bfrigon/alarm-clock-v2/README.md

alarm-clock
===========

3D Model render:

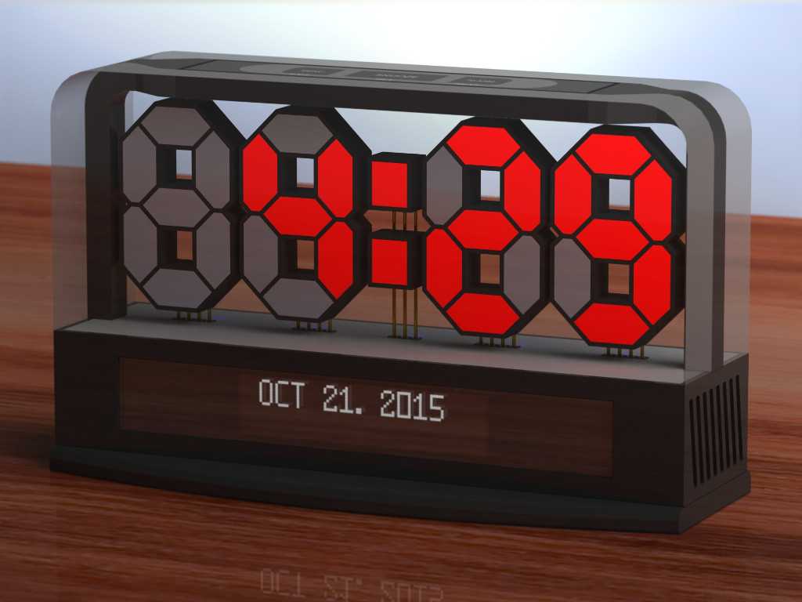
[picture p1: docs/model-render/front.jpg]
Front view
