bfrigon/alarm-clock-v2/drawings/mechanical/README.md

Index
-----

Doc ID        | Part #            | Description
--------------|-------------------|-------------------------------------------------
CLKV2-DWG-01  | CLKV2-PC-01       | RGB seven-segments digit - PCB
CLKV2-DWG-02  | CLKV2-ML-01       | RGB seven-segments digit - Diffuser shell
CLKV2-DWG-03  | CLKV2-PC-02       | RGB dot - PCB
CLKV2-DWG-04  | CLKV2-ML-02       | RGB dot - Diffuser shell
CLKV2-DWG-05  | CLKV2-PC-03       | RGB Digits display Base - PCB
CLKV2-DWG-06  | CLKV2-PC-04       | RGB Dots Base - PCB
CLKV2-DWG-07  | CLKV2-PC-05       | Front panel PCB
CLKV2-DWG-08  | CLKV2-PC-06       | Touch keypad PCB
CLKV2-DWG-09  | CLKV2-ML-03       | Touch keypad enclosure
CLKV2-DWG-10  | CLKV2-ML-04       | Top panel vertical support
CLKV2-DWG-11  | CLKV2-ML-05       | Front panel bracket
CLKV2-DWG-12  | CLKV2-PC-07       | Motherboard PCB
CLKV2-DWG-13  | CLKV2-ML-06       | Enclosure
CLKV2-DWG-14  | CLKV2-ML-07       | Bottom cover
CLKV2-DWG-15  | CLKV2-OVL-01      | Touch keypad overlay
CLKV2-DWG-20  | CLKV2-AS-01       | RGB seven-segments digit assembly
CLKV2-DWG-21  | CLKV2-AS-02       | RGB dots assembly
CLKV2-DWG-22  | CLKV2-AS-03       | Top panel assembly
CLKV2-DWG-23  | CLKV2-AS-04       | Motherboard assembly
CLKV2-DWG-24  | CLKV2-AS-05       | Arietta G25 assembly
CLKV2-DWG-30  | --                | Final assembly
