bfrigon/alarm-clock-v2/drawings/schematics/README.md

Index
-----

Doc ID        | Part #            | Description
--------------|-------------------|-------------------------------------------------
CLKV2-SCH-01  | CLKV2-PC-01       | RGB Seven-segment digit PCB
CLKV2-SCH-02  | CLKV2-PC-02       | RGB dot PCB
CLKV2-SCH-03  | CLKV2-PC-03       | Digits base PCB
CLKV2-SCH-04  | CLKV2-PC-04       | Dots base PCB
CLKV2-SCH-05  | CLKV2-PC-05       | Front panel PCB
CLKV2-SCH-06  | CLKV2-PC-06       | Touch keypad PCB
CLKV2-SCH-07  | CLKV2-PC-07       | Motherboard
