bfrigon/alarm-clock-v2/docs/model-render/back.jpg

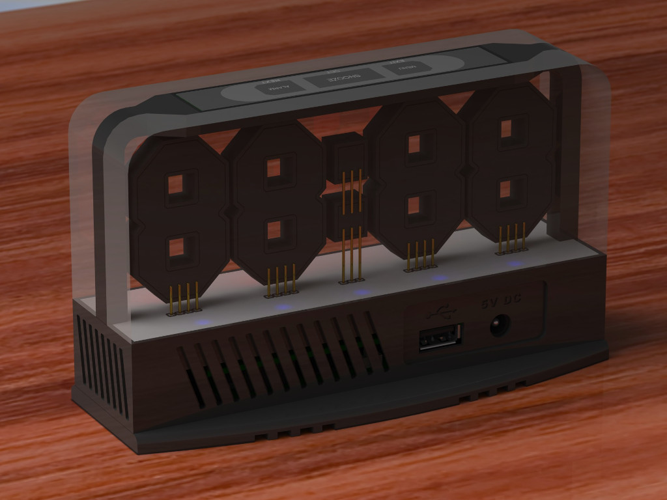
docs/model-render/back.jpg
