bfrigon/alarm-clock-v2/docs/model-render/dark.jpg

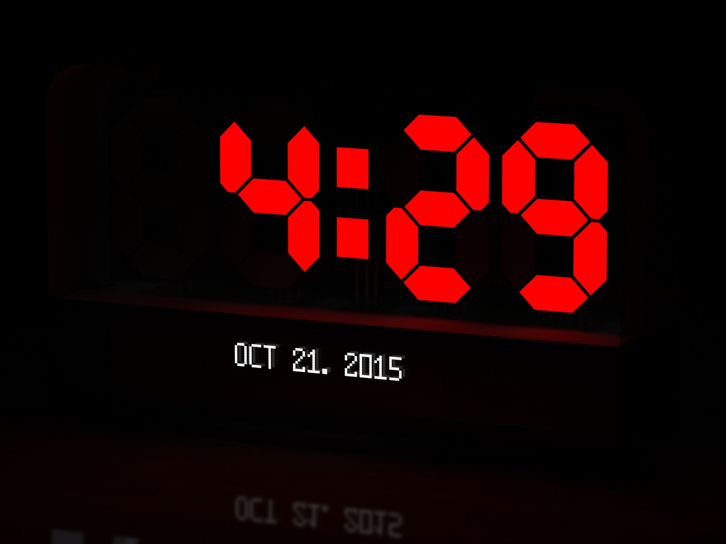
docs/model-render/dark.jpg
