bfrigon/alarm-clock-v2/docs/model-render/top.jpg

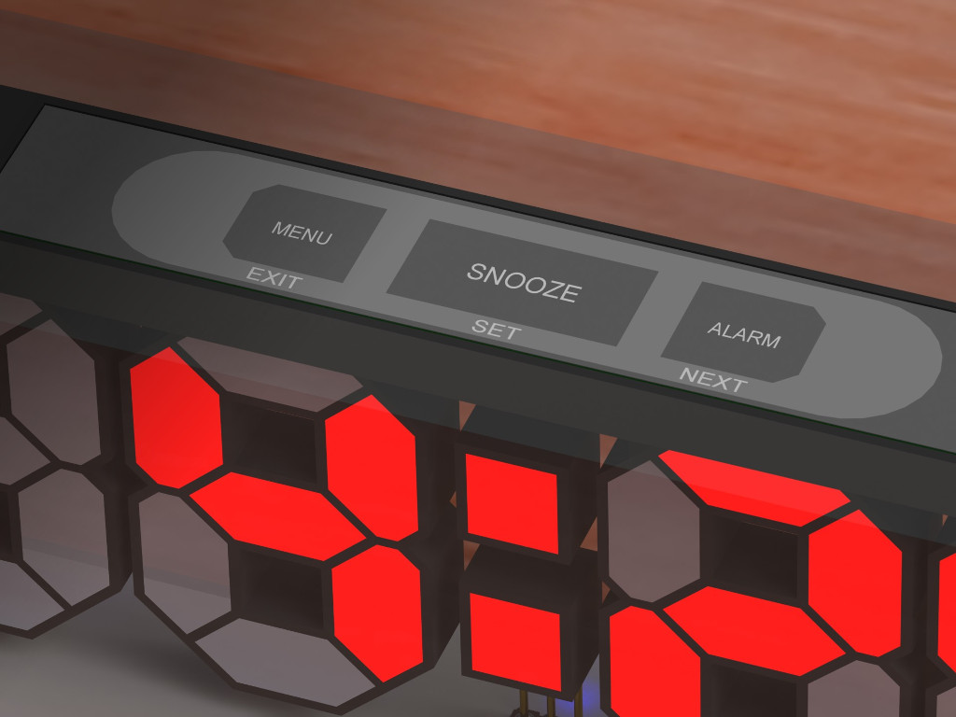
docs/model-render/top.jpg
