bfrigon/alarm-clock-v2/stl files/top panel - enclosure.stl

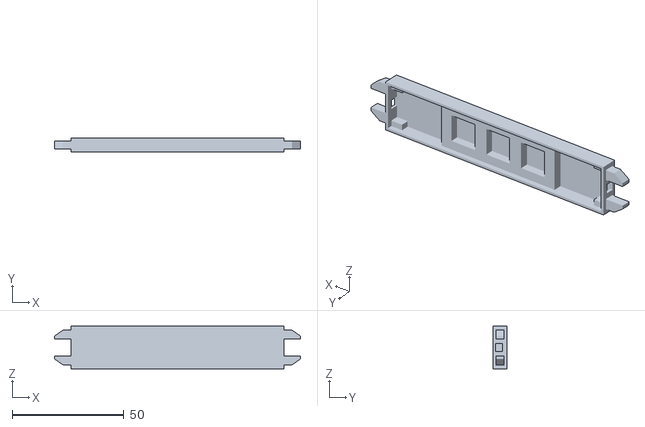
[picture p5: CAD file, 2015-11-26]
stl files/top panel - enclosure.stl
110.0 x 6.10 x 19.1
