bfrigon/alarm-clock-v2/stl files/bottom cover.stl

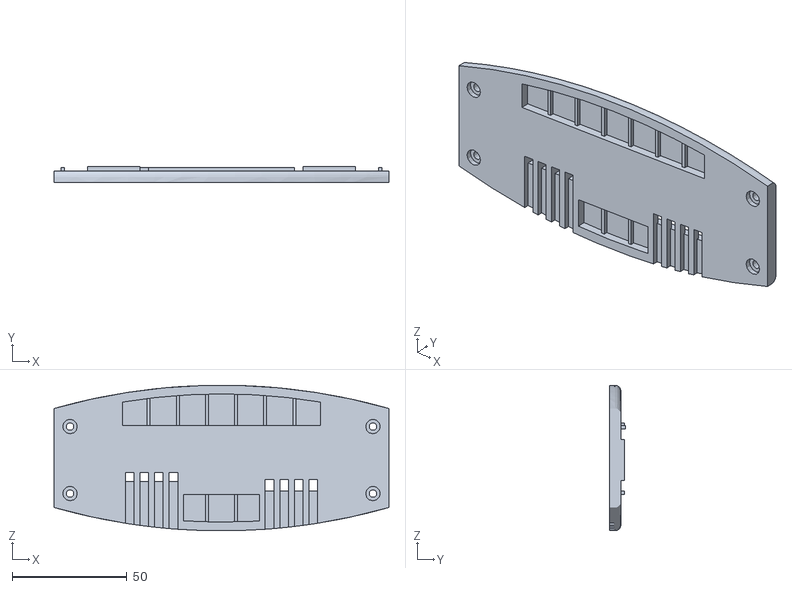
[picture p6: CAD file, 2015-11-26]
stl files/bottom cover.stl
146.1 x 7.11 x 63.4
