bfrigon/alarm-clock-v2/stl files/lcd window - bracket.stl

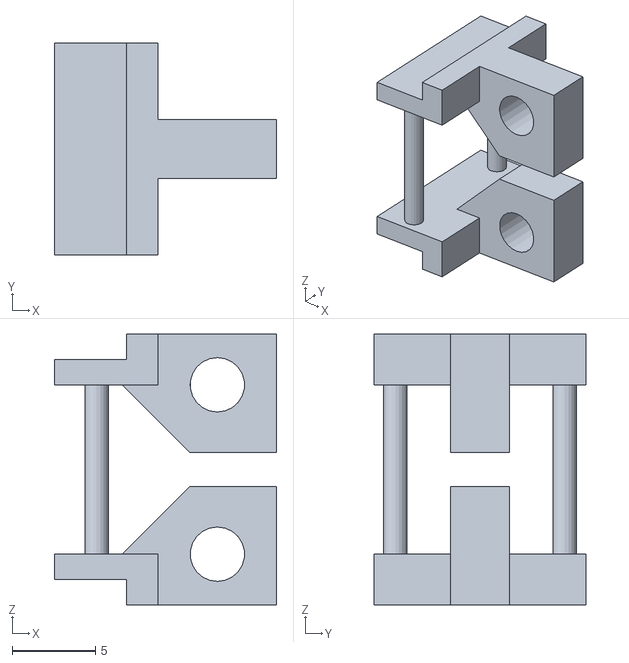
[picture p7: CAD file, 2015-11-26]
stl files/lcd window - bracket.stl
13.3 x 12.7 x 16.3
