bfrigon/alarm-clock-v2/stl files/enclosure.stl

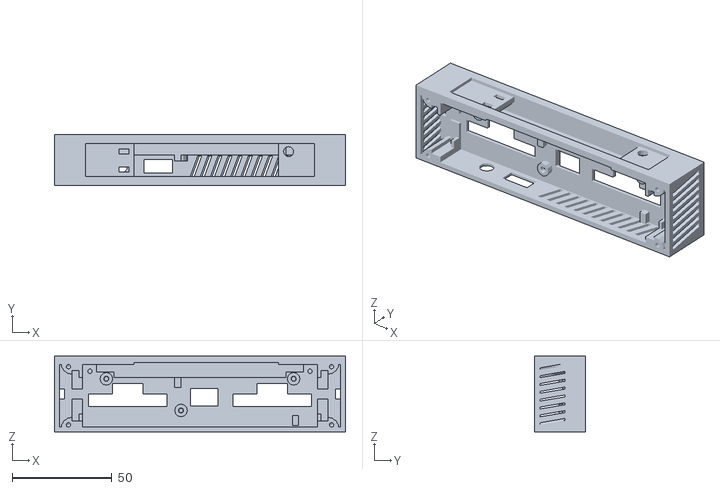
[picture p8: CAD file, 2015-11-26]
stl files/enclosure.stl
146.1 x 25.4 x 38.1
