bfrigon/alarm-clock-v2/stl files/top panel - vertical support.stl

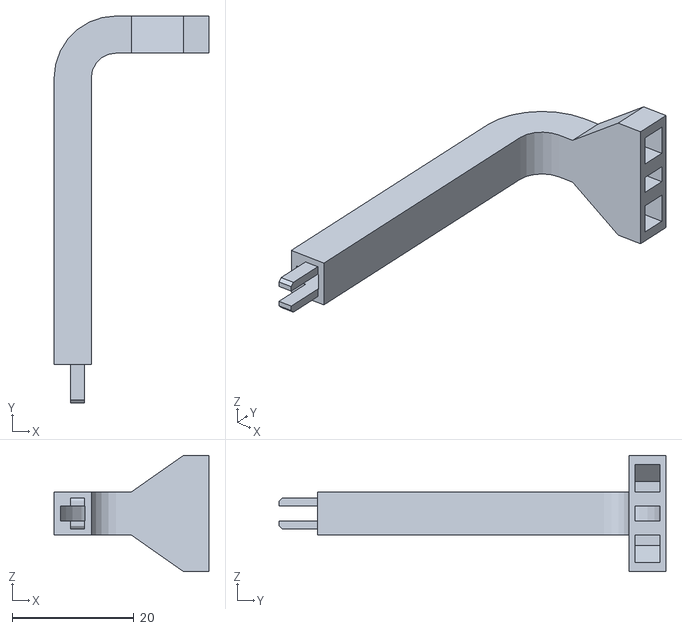
[picture p9: CAD file, 2015-11-26]
stl files/top panel - vertical support.stl
25.4 x 63.5 x 19.0
