bfrigon/alarm-clock-v2/stl files/diffuser shell - digit.stl

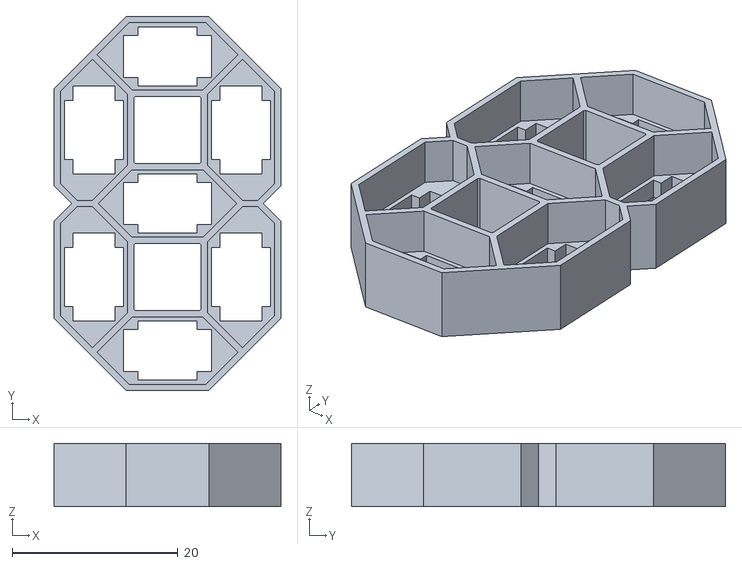
[picture p10: CAD file, 2015-11-04]
stl files/diffuser shell - digit.stl
27.4 x 45.2 x 7.62
