bfrigon/alarm-clock-v2/stl files/diffuser shell - dots.stl

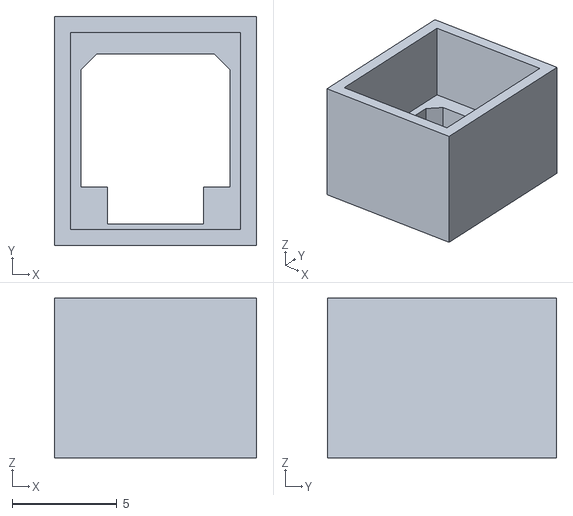
[picture p11: CAD file, 2015-11-04]
stl files/diffuser shell - dots.stl
9.65 x 10.9 x 7.62
