bfrigon/alarm-clock-v2/drawings/mechanical/clkv2-dwg-02.pdf

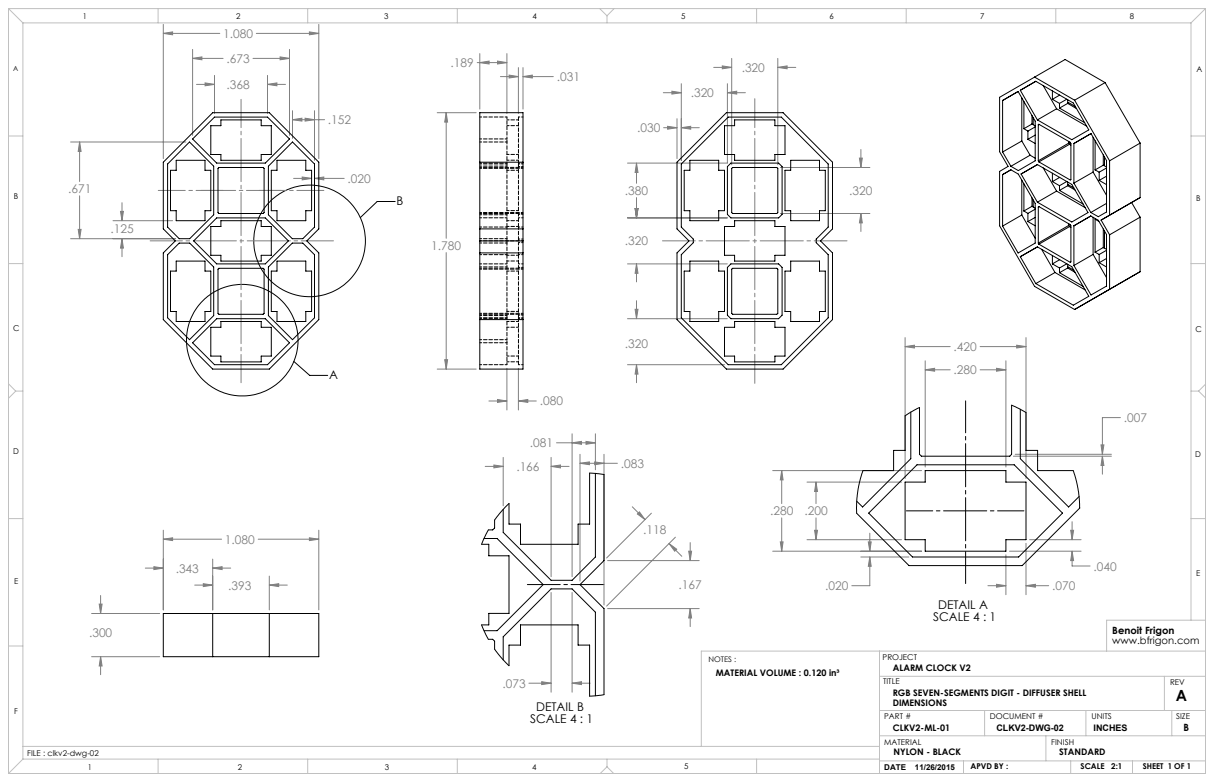
[picture p12: page 1]
DETAIL A SCALE 4 : 1; DETAIL B SCALE 4 : 1; SHEET 1 OF 1; DOCUMENT #; UNITS; SCALE 2:1; FILE : clkv2-dwg-02; APVD BY :

Benoit Frigon
www.bfrigon.com

NOTES :
MATERIAL VOLUME : 0.120 in³

PROJECT
ALARM CLOCK V2
TITLE
RGB SEVEN-SEGMENTS DIGIT - DIFFUSER SHELL
DIMENSIONS
PART #
CLKV2-ML-01
MATERIAL
NYLON - BLACK
DATE 11/26/2015
