bfrigon/alarm-clock-v2/drawings/mechanical/clkv2-dwg-04.pdf

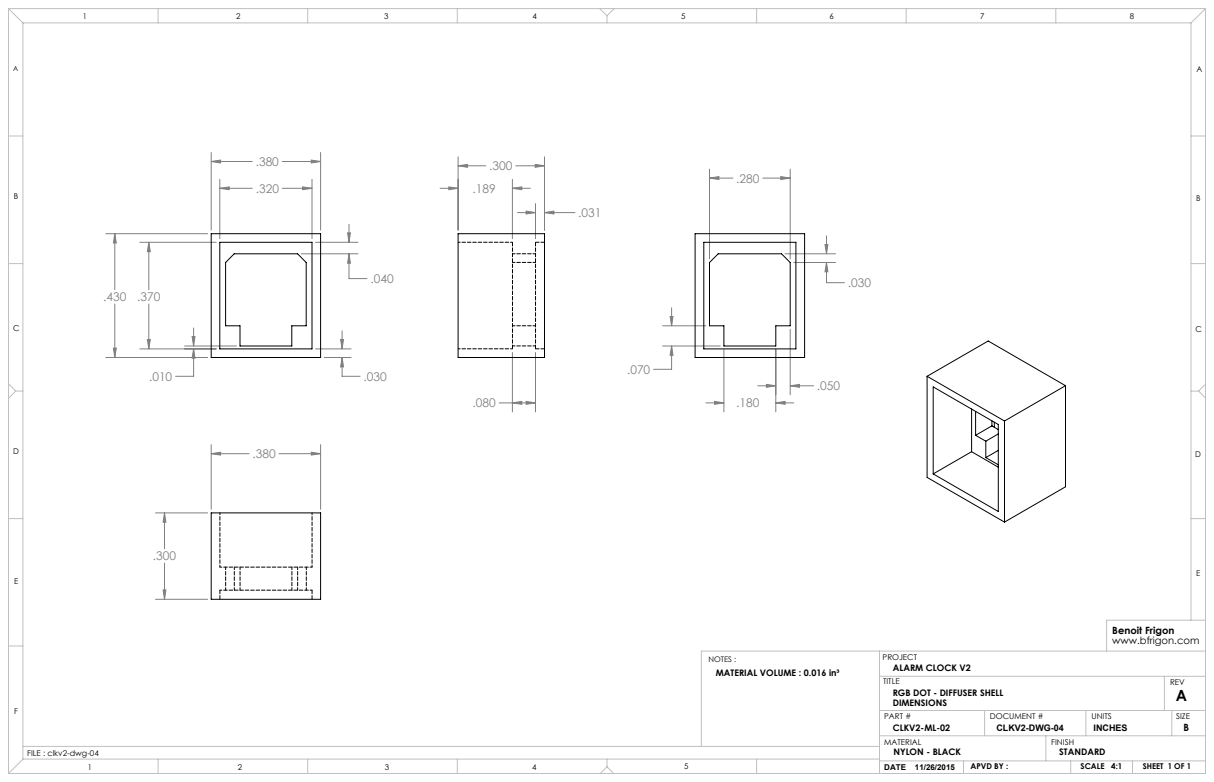
[picture p13: page 1]
SHEET 1 OF 1; DOCUMENT #; UNITS; SCALE 4:1; FILE : clkv2-dwg-04; APVD BY :

Benoit Frigon
www.bfrigon.com

NOTES :
MATERIAL VOLUME : 0.016 in³

PROJECT
ALARM CLOCK V2
TITLE
RGB DOT - DIFFUSER SHELL
DIMENSIONS
PART #
CLKV2-ML-02
MATERIAL
NYLON - BLACK
DATE 11/26/2015
