bfrigon/alarm-clock-v2/drawings/mechanical/clkv2-dwg-09.pdf

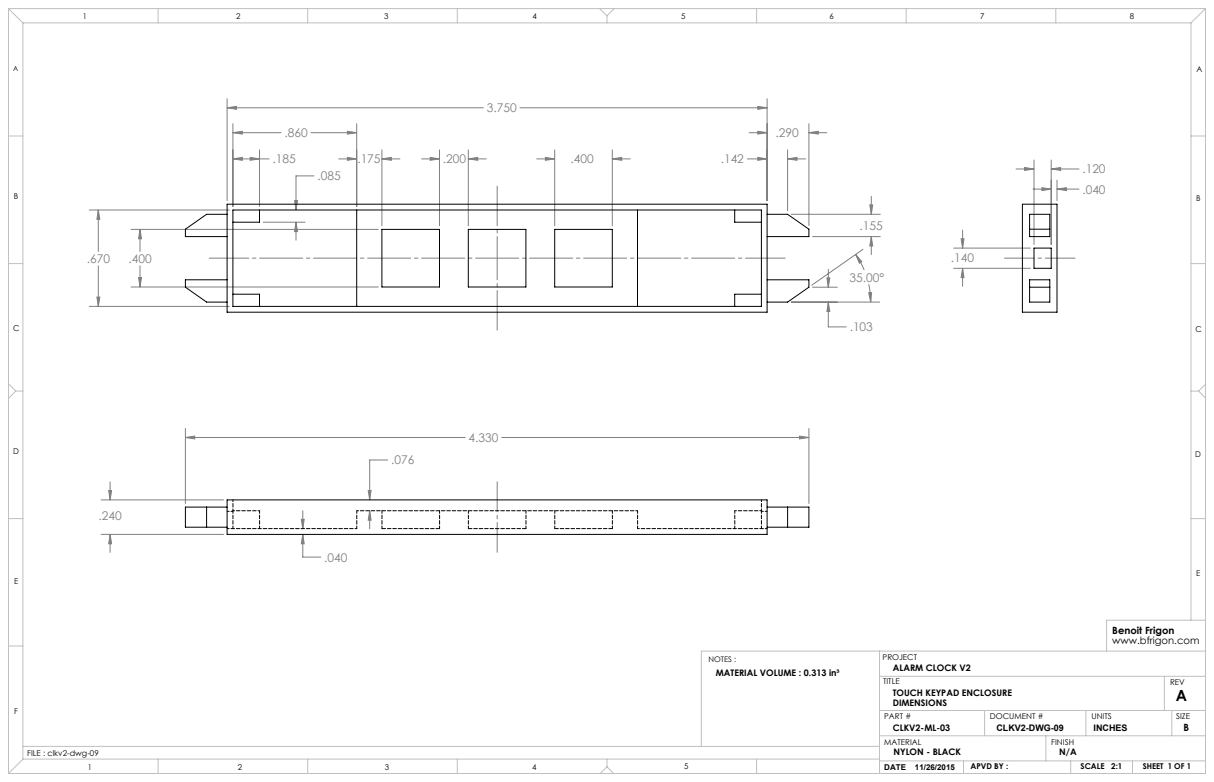
[picture p14: page 1]
SHEET 1 OF 1; ALARM CLOCK V2; TOUCH KEYPAD ENCLOSURE; PART #; DOCUMENT #; UNITS; DATE 11/26/2015; SCALE 2:1; FILE : clkv2-dwg-09; NYLON - BLACK; APVD BY :

Benoit Frigon
www.bfrigon.com

NOTES :
MATERIAL VOLUME : 0.313 in³
