bfrigon/alarm-clock-v2/drawings/mechanical/clkv2-dwg-10.pdf

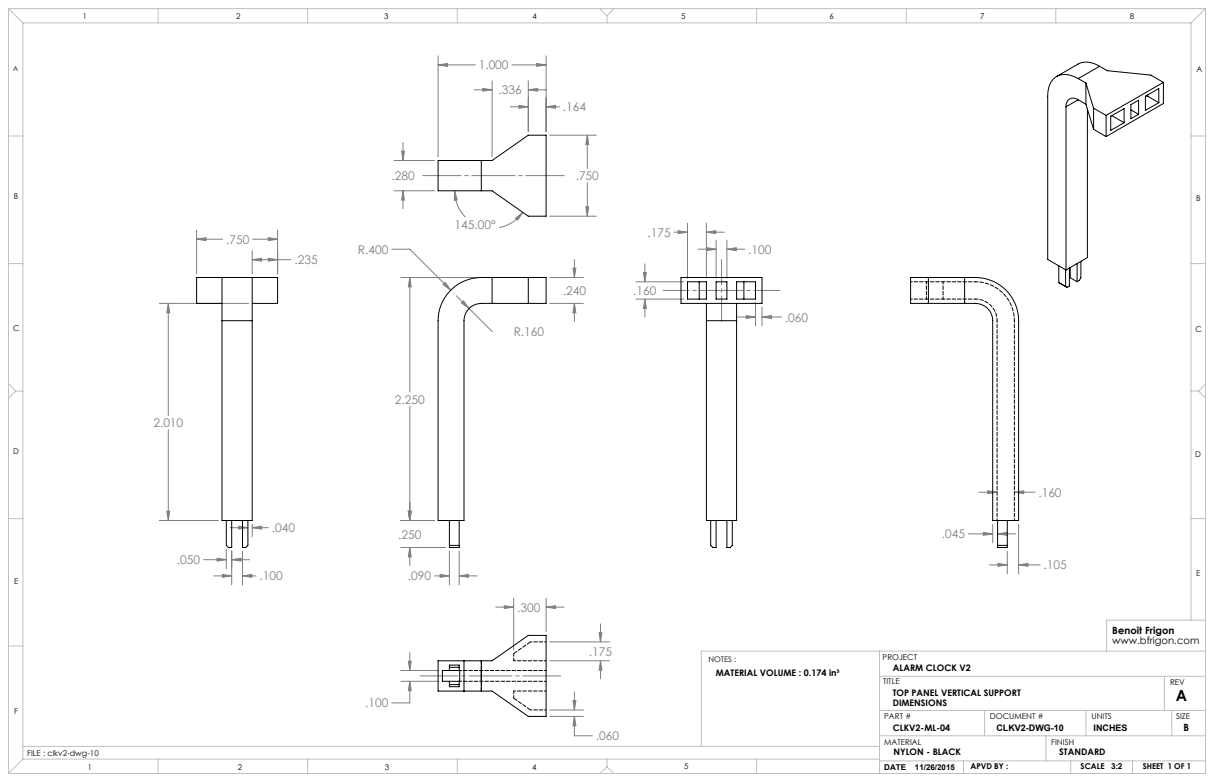
[picture p15: page 1]
SHEET 1 OF 1; DOCUMENT #; UNITS; SCALE 3:2; FILE : clkv2-dwg-10; APVD BY :

Benoit Frigon
www.bfrigon.com

NOTES :
MATERIAL VOLUME : 0.174 in³

PROJECT
ALARM CLOCK V2
TITLE
TOP PANEL VERTICAL SUPPORT
DIMENSIONS
PART #
CLKV2-ML-04
MATERIAL
NYLON - BLACK
DATE 11/26/2015
