bfrigon/alarm-clock-v2/drawings/mechanical/clkv2-dwg-11.pdf

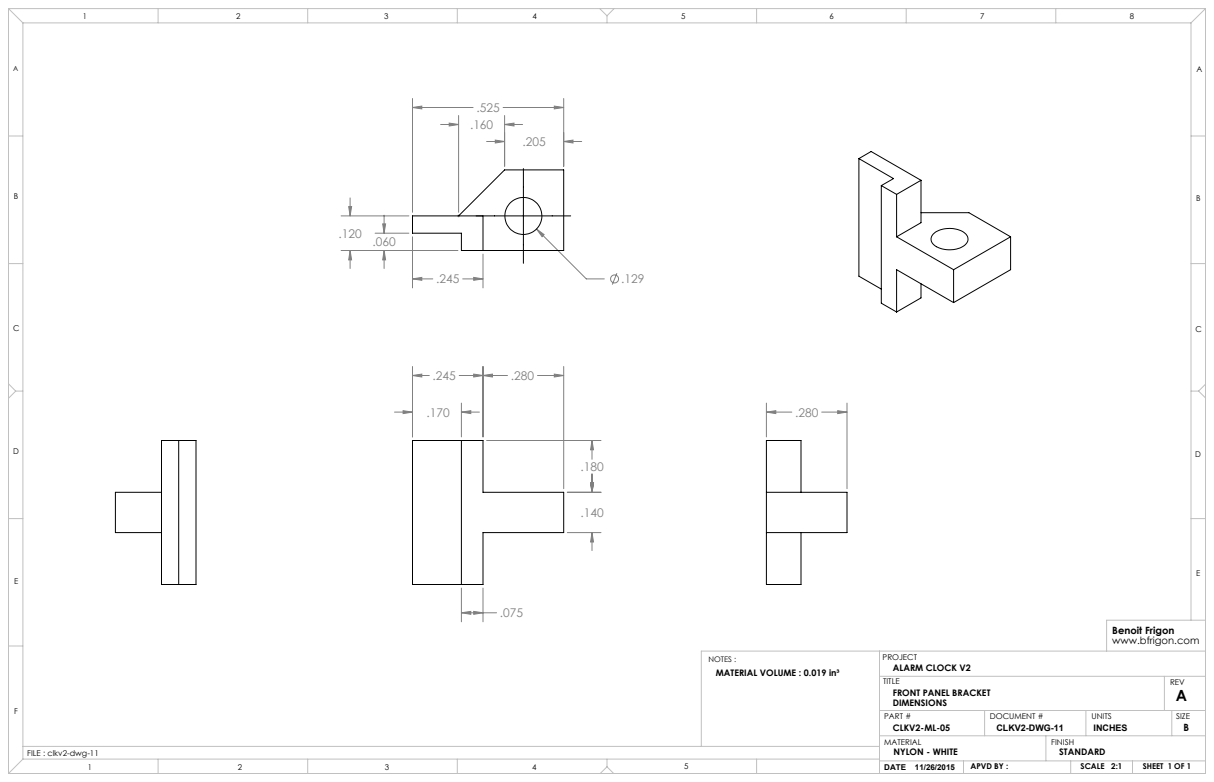
[picture p16: page 1]
SHEET 1 OF 1; ALARM CLOCK V2; FRONT PANEL BRACKET; PART #; DOCUMENT #; UNITS; DATE 11/26/2015; SCALE 2:1; FILE : clkv2-dwg-11; NYLON - WHITE; APVD BY :

Benoit Frigon
www.bfrigon.com

NOTES :
MATERIAL VOLUME : 0.019 in³
