bfrigon/alarm-clock-v2/drawings/mechanical/clkv2-dwg.pdf

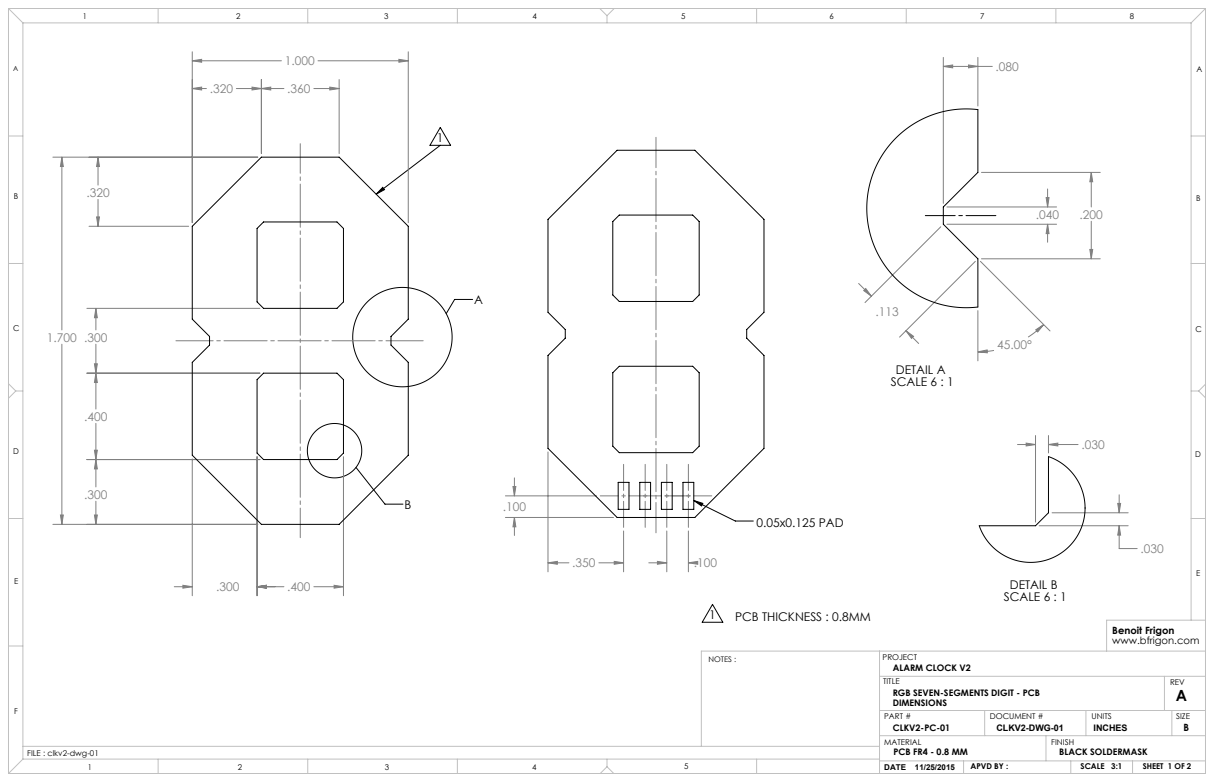
[picture p17: page 1]
DETAIL A SCALE 6 : 1; DETAIL B SCALE 6 : 1; 0.05x0.125 PAD; 1 PCB THICKNESS : 0.8MM; SHEET 1 OF 2; REV; DOCUMENT #; UNITS; INCHES; SIZE B; CLKV2-DWG-01; SCALE 3:1; FILE : clkv2-dwg-01; FINISH BLACK SOLDERMASK; NOTES :; APVD BY :

Benoit Frigon
www.bfrigon.com

PROJECT
ALARM CLOCK V2
TITLE
RGB SEVEN-SEGMENTS DIGIT - PCB
DIMENSIONS
PART #
CLKV2-PC-01
MATERIAL
PCB FR4 - 0.8 MM
DATE 11/25/2015

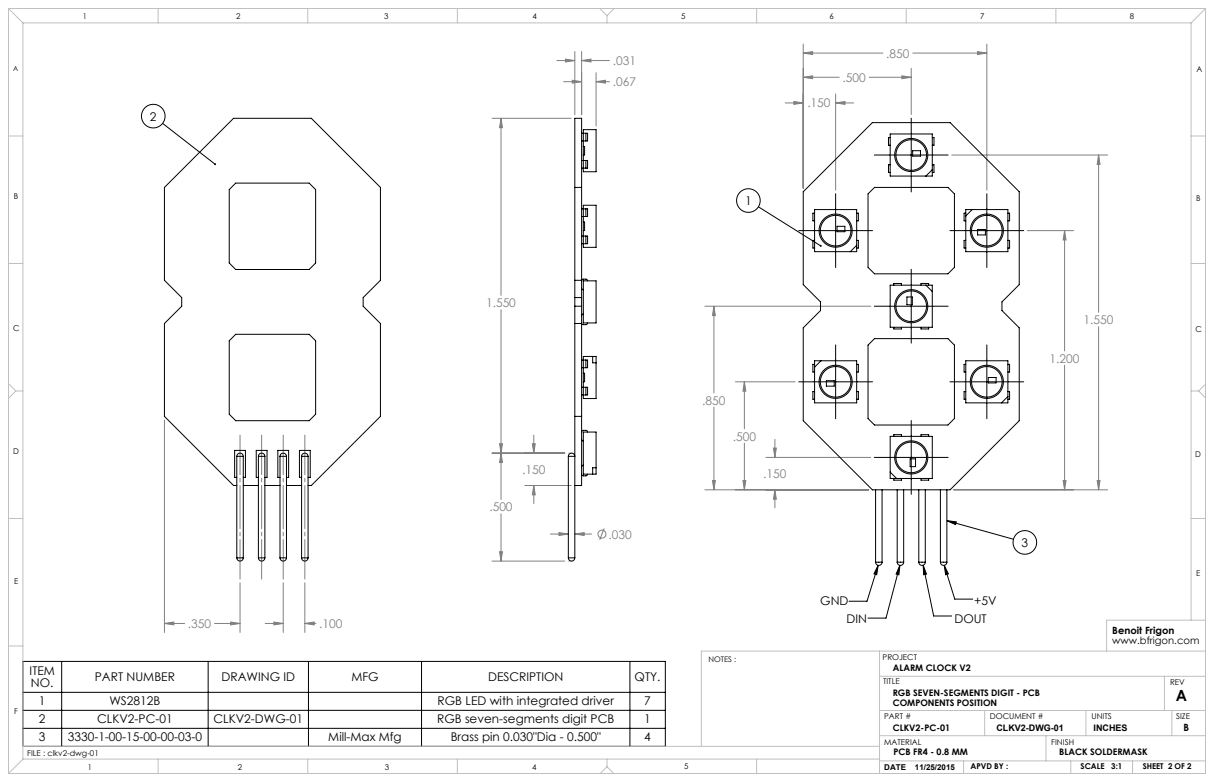
[picture p18: page 2]
GND; DIN; DOUT; SHEET 2 OF 2; REV; DOCUMENT #; UNITS; SIZE; CLKV2-DWG-01; SCALE 3:1; BLACK SOLDERMASK; NOTES :

Benoit Frigon
www.bfrigon.com

PROJECT
ALARM CLOCK V2
TITLE
RGB SEVEN-SEGMENTS DIGIT - PCB
COMPONENTS POSITION
PART #
CLKV2-PC-01
PCB FR4 - 0.8 MM

ITEM NO. | PART NUMBER | DRAWING ID | MFG | DESCRIPTION | QTY.
1 | WS2812B | | | RGB LED with integrated driver | 7
2 | CLKV2-PC-01 | CLKV2-DWG-01 | | RGB seven-segments digit PCB | 1
3 | 3330-1-00-15-00-00-03-0 | | Mill-Max Mfg | Brass pin 0.030"Dia - 0.500" | 4

DETAIL A SCALE 4 : 1; DETAIL B SCALE 4 : 1; SHEET 1 OF 1; REV; DOCUMENT #; UNITS; SIZE; CLKV2-DWG-02; SCALE 2:1; STANDARD

Benoit Frigon
www.bfrigon.com

NOTES :
MATERIAL VOLUME : 0.120 in³

PROJECT
ALARM CLOCK V2
TITLE
RGB SEVEN-SEGMENTS DIGIT - DIFFUSER SHELL
DIMENSIONS
PART #
CLKV2-ML-01
NYLON - BLACK
DATE 11/26/2015

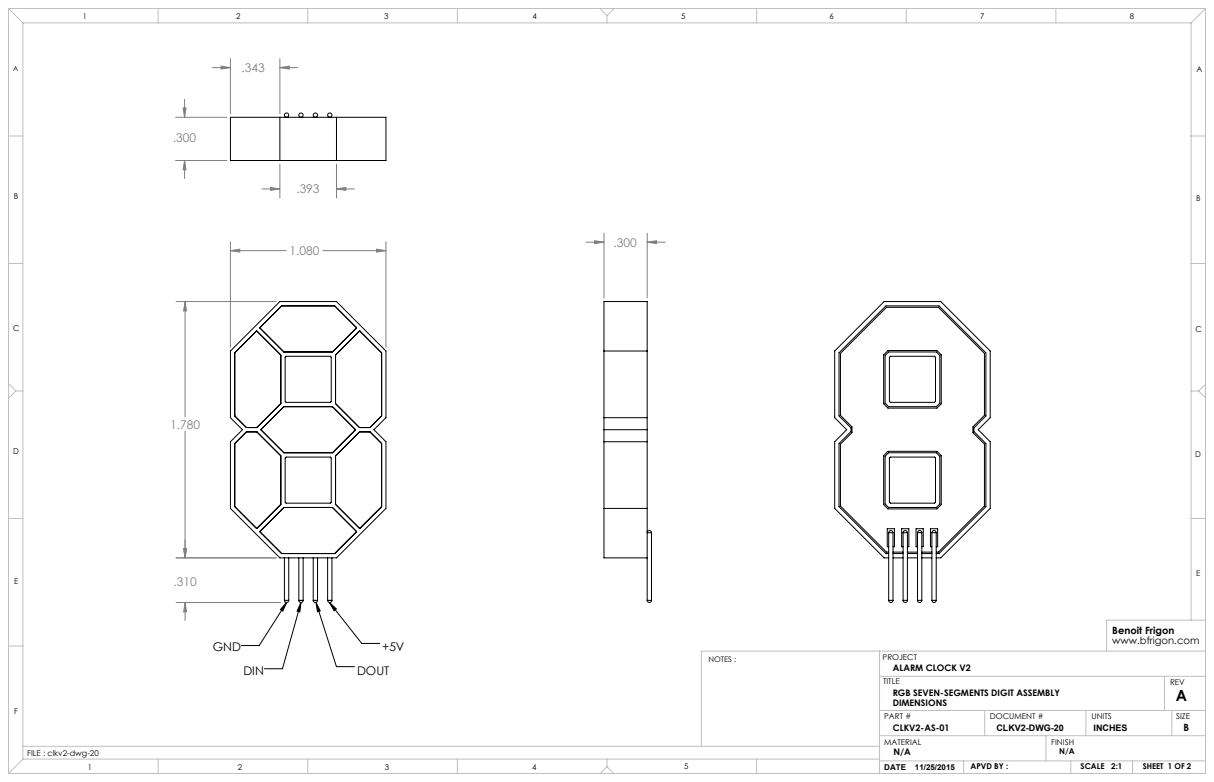
[picture p19: page 4]
GND; DIN; DOUT; SHEET 1 OF 2; REV; DOCUMENT #; UNITS; SIZE; CLKV2-DWG-20; NOTES :

Benoit Frigon
www.bfrigon.com

PROJECT
ALARM CLOCK V2
TITLE
RGB SEVEN-SEGMENTS DIGIT ASSEMBLY
DIMENSIONS
PART #
CLKV2-AS-01

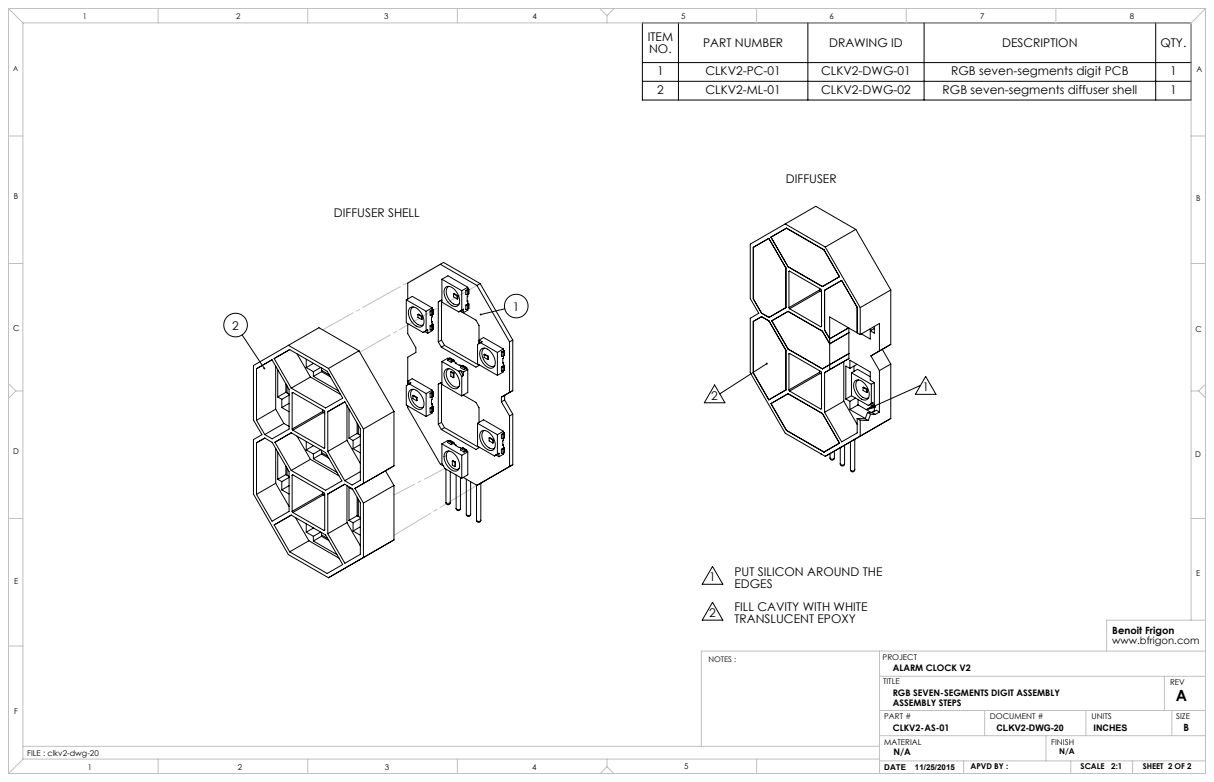
[picture p20: page 5]
DIFFUSER SHELL; DIFFUSER; SHEET 2 OF 2; REV; DOCUMENT #; UNITS; SIZE; CLKV2-DWG-20; NOTES :

ITEM NO. | PART NUMBER | DRAWING ID | DESCRIPTION | QTY.

1 | CLKV2-PC-01 | CLKV2-DWG-01 | RGB seven-segments digit PCB | 1
2 | CLKV2-ML-01 | CLKV2-DWG-02 | RGB seven-segments diffuser shell | 1

PUT SILICON AROUND THE
EDGES
2 FILL CAVITY WITH WHITE
TRANSLUCENT EPOXY

Benoit Frigon
www.bfrigon.com

PROJECT
ALARM CLOCK V2
TITLE
RGB SEVEN-SEGMENTS DIGIT ASSEMBLY
ASSEMBLY STEPS
PART #
CLKV2-AS-01

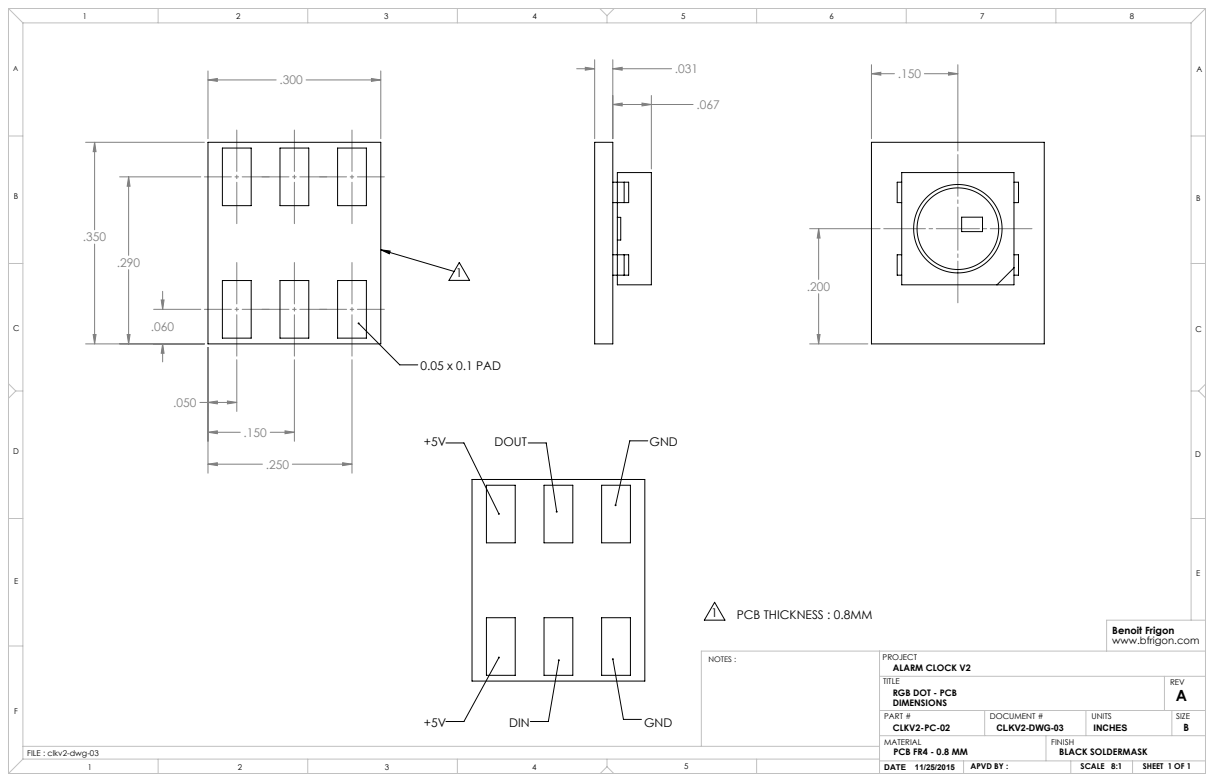
[picture p21: page 6]
0.05 x 0.1 PAD; DIN; GND; DOUT; 1 PCB THICKNESS : 0.8MM; REV; DOCUMENT #; UNITS; SIZE; CLKV2-DWG-03; SCALE 8:1; BLACK SOLDERMASK; NOTES :

Benoit Frigon
www.bfrigon.com

PROJECT
ALARM CLOCK V2
TITLE
RGB DOT - PCB
DIMENSIONS
PART #
CLKV2-PC-02
PCB FR4 - 0.8 MM

REV; DOCUMENT #; UNITS; SIZE; CLKV2-DWG-04; SCALE 4:1

Benoit Frigon
www.bfrigon.com

NOTES :
MATERIAL VOLUME : 0.016 in³

PROJECT
ALARM CLOCK V2
TITLE
RGB DOT - DIFFUSER SHELL
DIMENSIONS
PART #
CLKV2-ML-02
NYLON - BLACK
DATE 11/26/2015

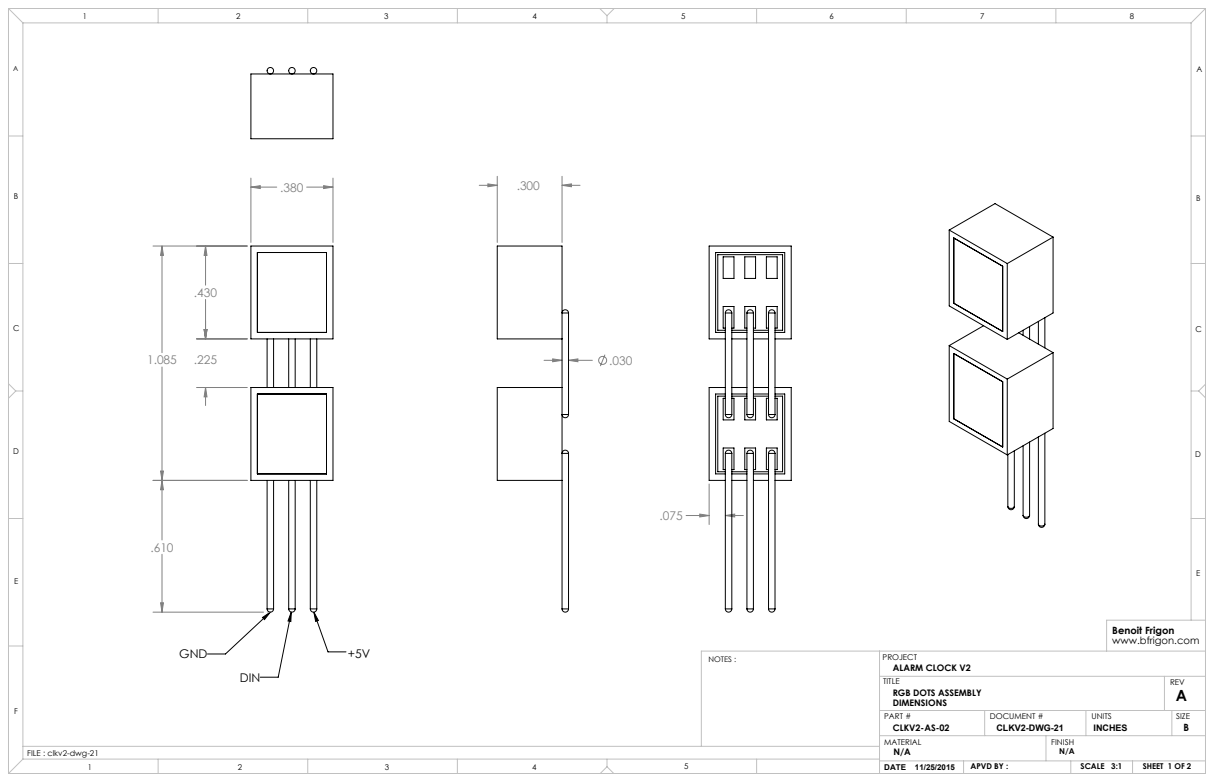
[picture p22: page 8]
GND; DIN; SHEET 1 OF 2; ALARM CLOCK V2 TITLE RGB DOTS ASSEMBLY; REV; PART # CLKV2-AS-02; DOCUMENT #; UNITS; SIZE; CLKV2-DWG-21; SCALE 3:1; PROJECT; NOTES :; DIMENSIONS

Benoit Frigon
www.bfrigon.com

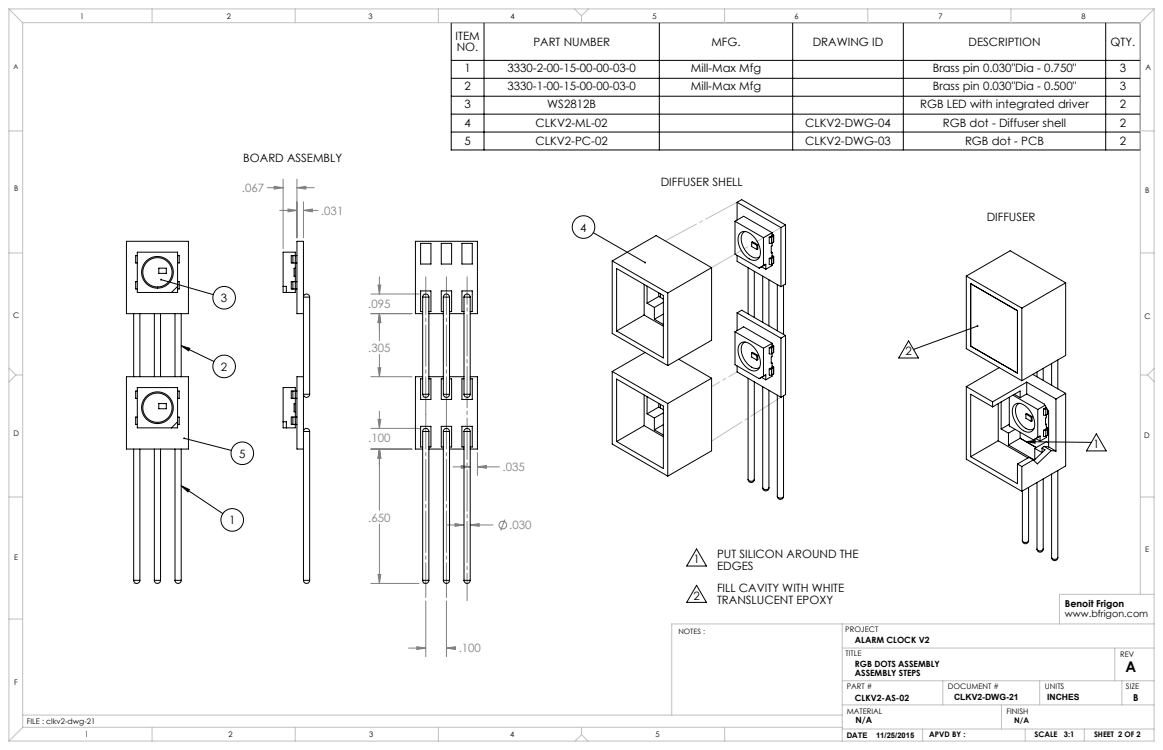
[picture p23: page 9]
BOARD ASSEMBLY; DIFFUSER SHELL; DIFFUSER; SHEET 2 OF 2; ALARM CLOCK V2 TITLE RGB DOTS ASSEMBLY; REV; PART # CLKV2-AS-02; DOCUMENT #; UNITS; SIZE; CLKV2-DWG-21; SCALE 3:1; PROJECT; NOTES :; ASSEMBLY STEPS

ITEM NO. | PART NUMBER | MFG. | DRAWING ID | DESCRIPTION | QTY.

1 | 3330-2-00-15-00-00-03-0 | Mill-Max Mfg | | Brass pin 0.030"Dia - 0.750" | 3
2 | 3330-1-00-15-00-00-03-0 | Mill-Max Mfg | | Brass pin 0.030"Dia - 0.500" | 3
3 | WS2812B | | | RGB LED with integrated driver | 2
4 | CLKV2-ML-02 | | CLKV2-DWG-04 | RGB dot - Diffuser shell | 2
5 | CLKV2-PC-02 | | CLKV2-DWG-03 | RGB dot - PCB | 2

PUT SILICON AROUND THE
EDGES
FILL CAVITY WITH WHITE
TRANSLUCENT EPOXY

Benoit Frigon
www.bfrigon.com

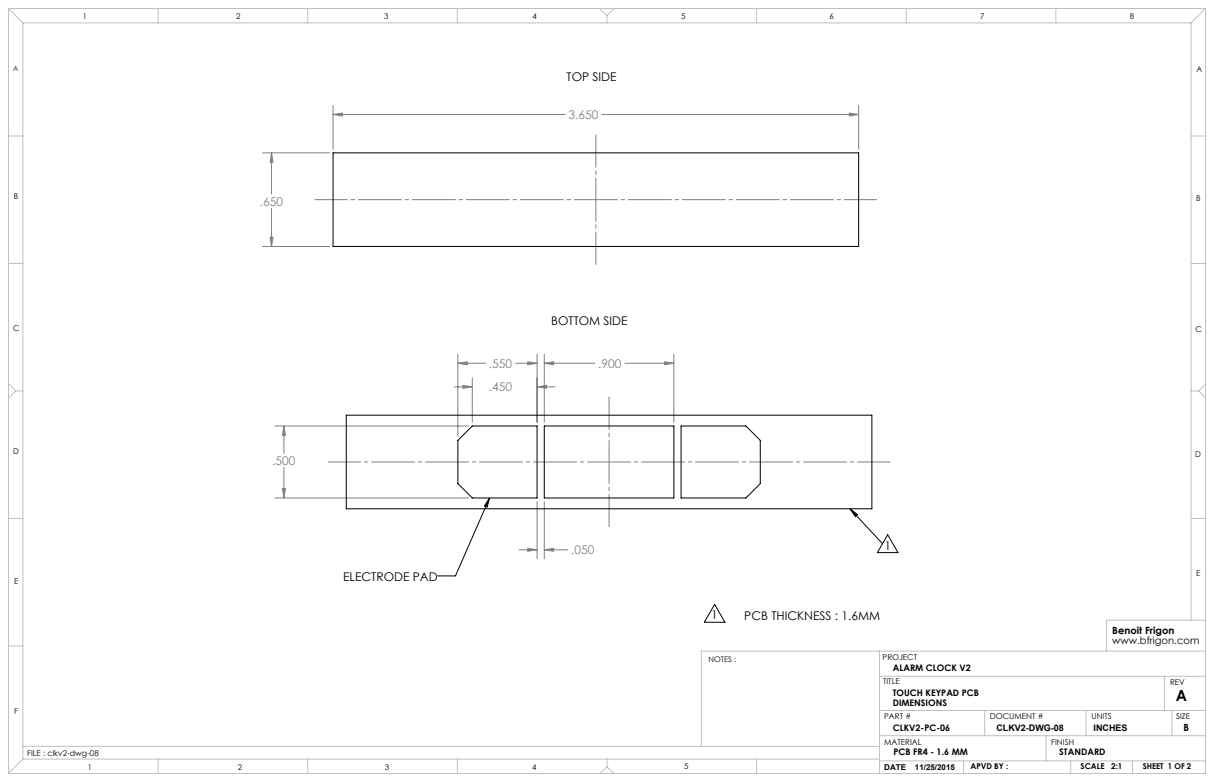
[picture p24: page 10]
ELECTRODE PAD; PCB THICKNESS : 1.6MM; TOP SIDE; BOTTOM SIDE; SHEET 1 OF 2; REV; DOCUMENT #; UNITS; SIZE; CLKV2-DWG-08; NOTES :

Benoit Frigon
www.bfrigon.com

PROJECT
ALARM CLOCK V2
TITLE
TOUCH KEYPAD PCB
DIMENSIONS
PART #
CLKV2-PC-06
PCB FR4 - 1.6 MM

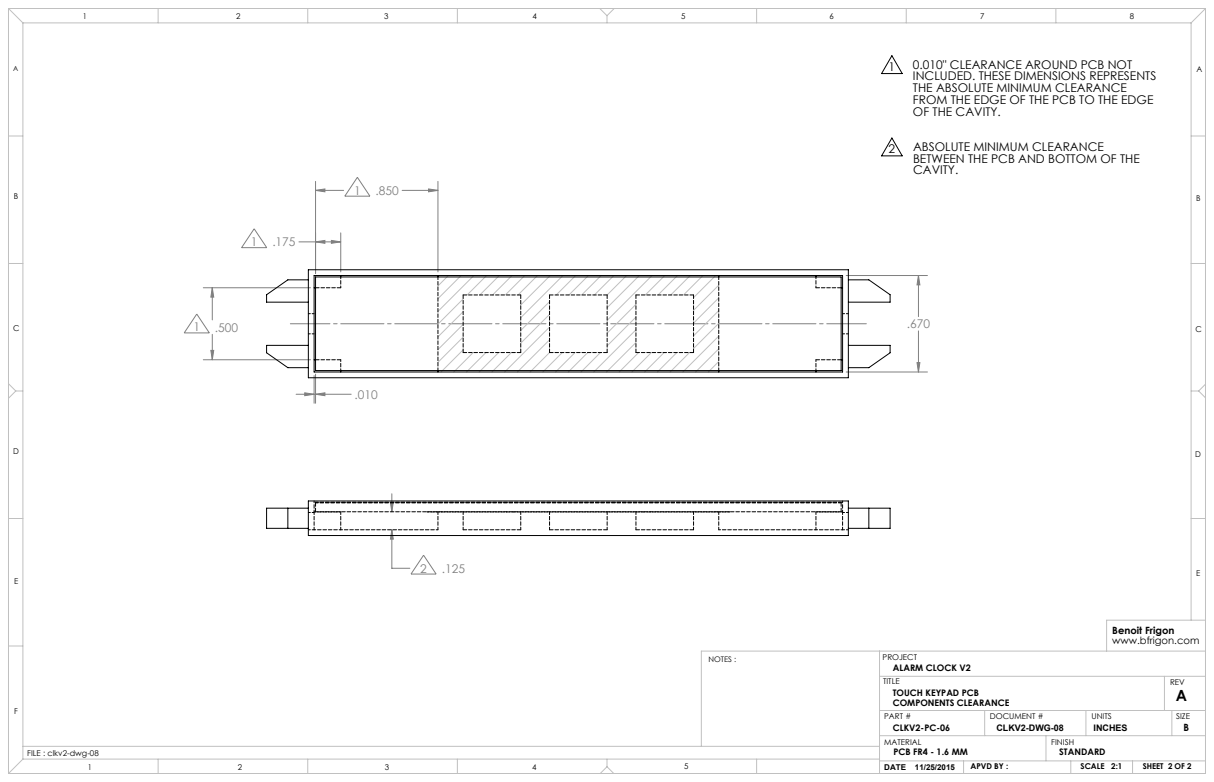
[picture p25: page 11]
SHEET 2 OF 2; REV; DOCUMENT #; UNITS; SIZE; CLKV2-DWG-08; NOTES :

0.010" CLEARANCE AROUND PCB NOT
INCLUDED. THESE DIMENSIONS REPRESENTS
THE ABSOLUTE MINIMUM CLEARANCE
FROM THE EDGE OF THE PCB TO THE EDGE
OF THE CAVITY.

ABSOLUTE MINIMUM CLEARANCE
BETWEEN THE PCB AND BOTTOM OF THE
CAVITY.

Benoit Frigon
www.bfrigon.com

PROJECT
ALARM CLOCK V2
TITLE
TOUCH KEYPAD PCB
COMPONENTS CLEARANCE
PART #
CLKV2-PC-06
PCB FR4 - 1.6 MM

ALARM CLOCK V2 TITLE TOUCH KEYPAD ENCLOSURE; REV; PART # CLKV2-ML-03; DOCUMENT #; UNITS; SIZE; DATE 11/26/2015; CLKV2-DWG-09; PROJECT; NYLON - BLACK; DIMENSIONS

Benoit Frigon
www.bfrigon.com

NOTES :
MATERIAL VOLUME : 0.313 in³

REV; DOCUMENT #; UNITS; SIZE; CLKV2-DWG-10; SCALE 3:2

Benoit Frigon
www.bfrigon.com

NOTES :
MATERIAL VOLUME : 0.174 in³

PROJECT
ALARM CLOCK V2
TITLE
TOP PANEL VERTICAL SUPPORT
DIMENSIONS
PART #
CLKV2-ML-04
NYLON - BLACK
DATE 11/26/2015

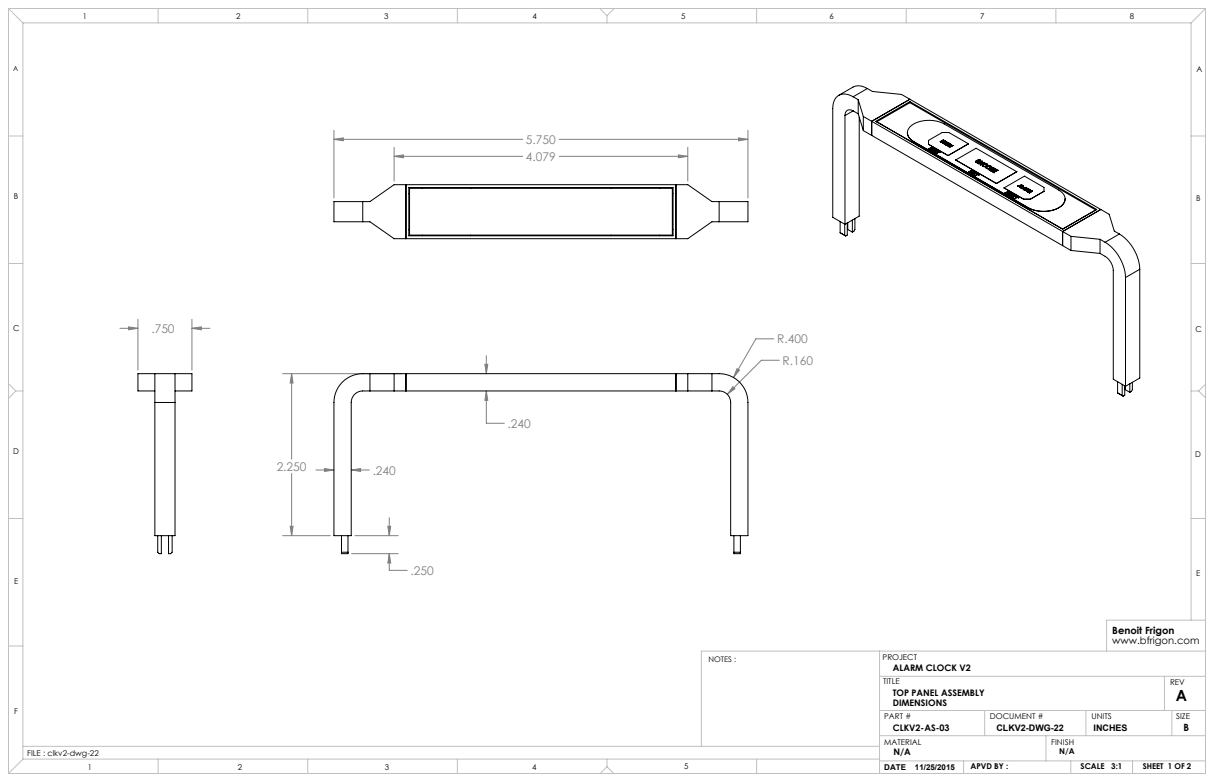
[picture p26: page 14]
SHEET 1 OF 2; ALARM CLOCK V2 TITLE TOP PANEL ASSEMBLY; REV; PART # CLKV2-AS-03; DOCUMENT #; UNITS; SIZE; CLKV2-DWG-22; SCALE 3:1; PROJECT; NOTES :; DIMENSIONS

Benoit Frigon
www.bfrigon.com

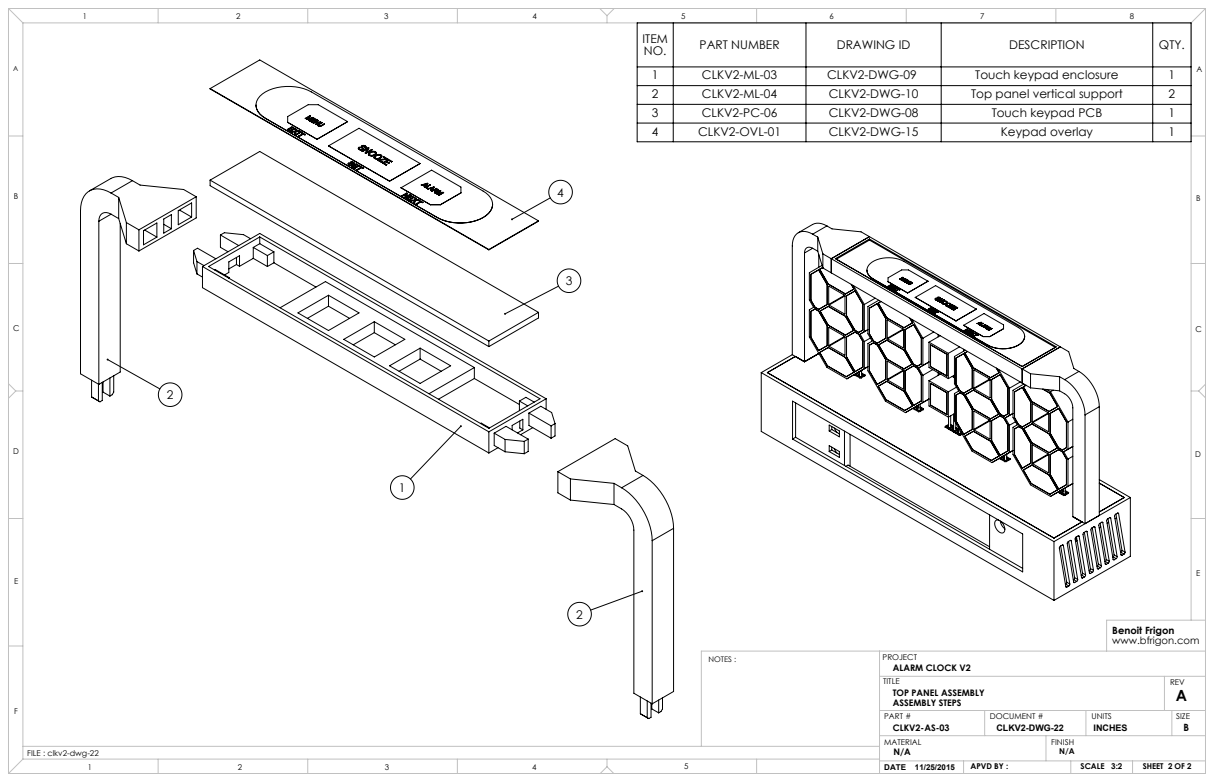
[picture p27: page 15]
SHEET 2 OF 2; ALARM CLOCK V2 TITLE TOP PANEL ASSEMBLY; REV; PART # CLKV2-AS-03; DOCUMENT #; UNITS; SIZE; CLKV2-DWG-22; SCALE 3:2; PROJECT; NOTES :; ASSEMBLY STEPS

ITEM NO. | PART NUMBER | DRAWING ID | DESCRIPTION | QTY.

1 | CLKV2-ML-03 | CLKV2-DWG-09 | Touch keypad enclosure | 1
2 | CLKV2-ML-04 | CLKV2-DWG-10 | Top panel vertical support | 2
3 | CLKV2-PC-06 | CLKV2-DWG-08 | Touch keypad PCB | 1
4 | CLKV2-OVL-01 | CLKV2-DWG-15 | Keypad overlay | 1

Benoit Frigon
www.bfrigon.com

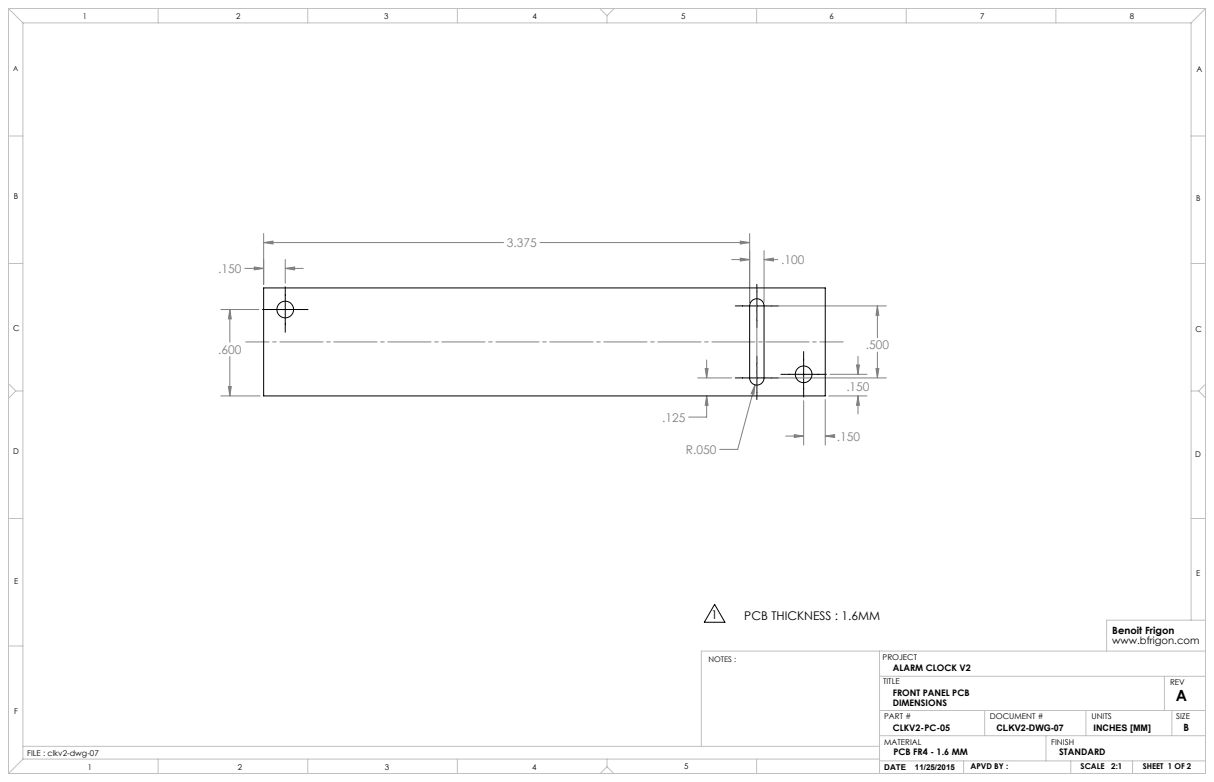
[picture p28: page 16]
PCB THICKNESS : 1.6MM; SHEET 1 OF 2; REV; DOCUMENT #; UNITS; INCHES [MM]; SIZE; CLKV2-DWG-07; NOTES :

Benoit Frigon
www.bfrigon.com

PROJECT
ALARM CLOCK V2
TITLE
FRONT PANEL PCB
DIMENSIONS
PART #
CLKV2-PC-05
PCB FR4 - 1.6 MM

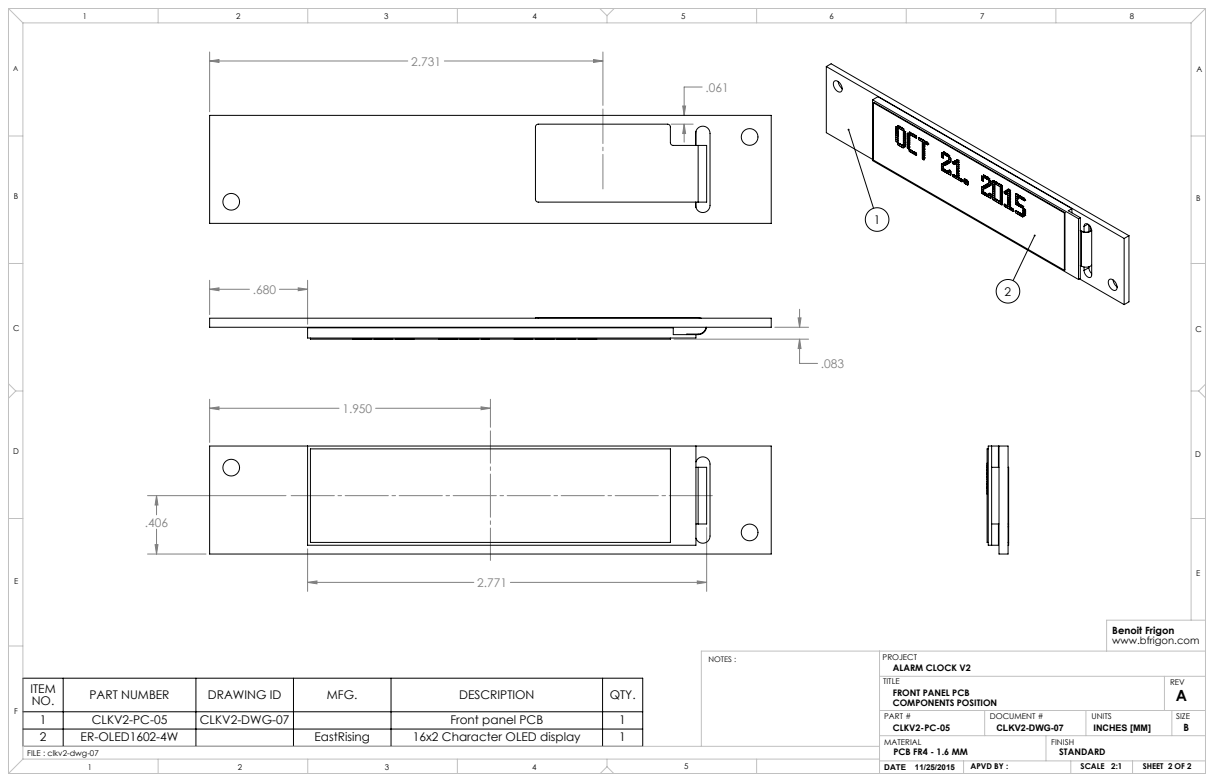
[picture p29: page 17]
SHEET 2 OF 2; REV; DOCUMENT #; UNITS; INCHES [MM]; SIZE; CLKV2-DWG-07; NOTES :

Benoit Frigon
www.bfrigon.com

PROJECT
ALARM CLOCK V2
TITLE
FRONT PANEL PCB
COMPONENTS POSITION
PART #
CLKV2-PC-05
PCB FR4 - 1.6 MM

ITEM NO. | PART NUMBER | DRAWING ID | MFG. | DESCRIPTION | QTY.
1 | CLKV2-PC-05 | CLKV2-DWG-07 | | Front panel PCB | 1
2 | ER-OLED1602-4W | | EastRising | 16x2 Character OLED display | 1

ALARM CLOCK V2 TITLE FRONT PANEL BRACKET; REV; PART # CLKV2-ML-05; DOCUMENT #; UNITS; SIZE; DATE 11/26/2015; CLKV2-DWG-11; PROJECT; NYLON - WHITE; DIMENSIONS

Benoit Frigon
www.bfrigon.com

NOTES :
MATERIAL VOLUME : 0.019 in³

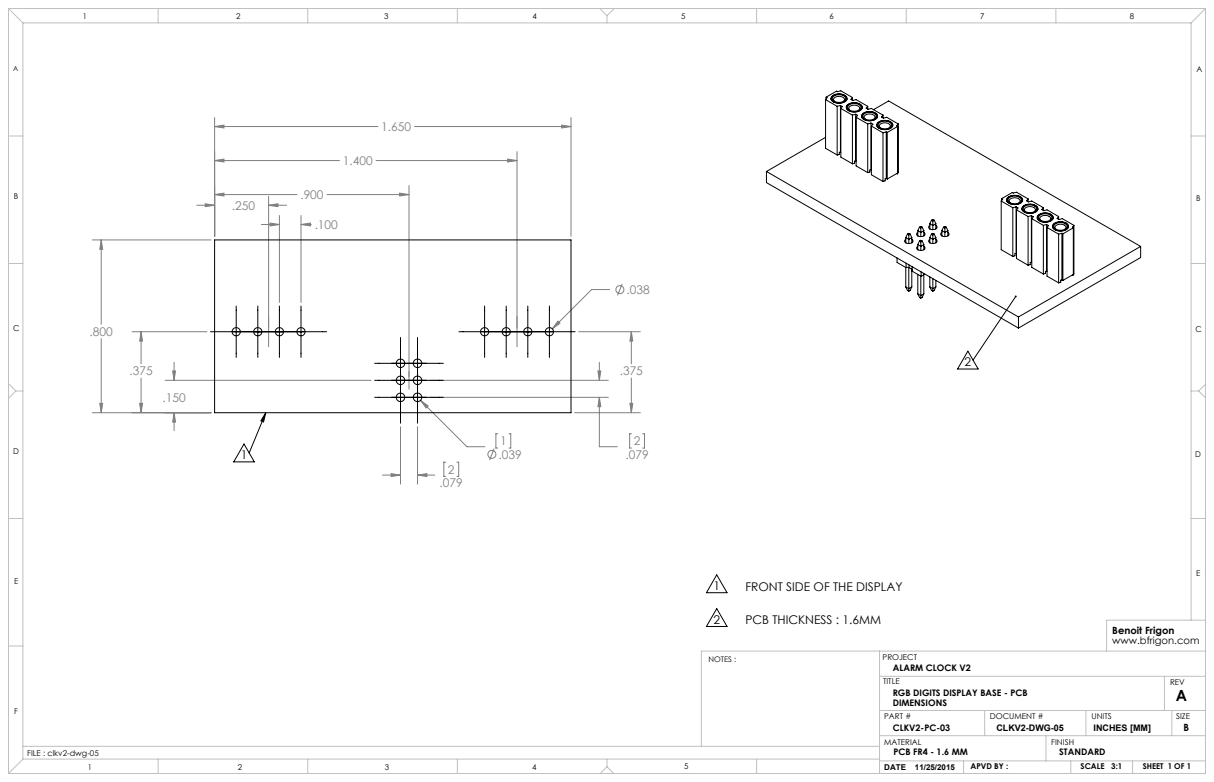
[picture p30: page 19]
FRONT SIDE OF THE DISPLAY; PCB THICKNESS : 1.6MM; REV; DOCUMENT #; UNITS; INCHES [MM]; SIZE; CLKV2-DWG-05; SCALE 3:1; NOTES :

Benoit Frigon
www.bfrigon.com

PROJECT
ALARM CLOCK V2
TITLE
RGB DIGITS DISPLAY BASE - PCB
DIMENSIONS
PART #
CLKV2-PC-03
PCB FR4 - 1.6 MM

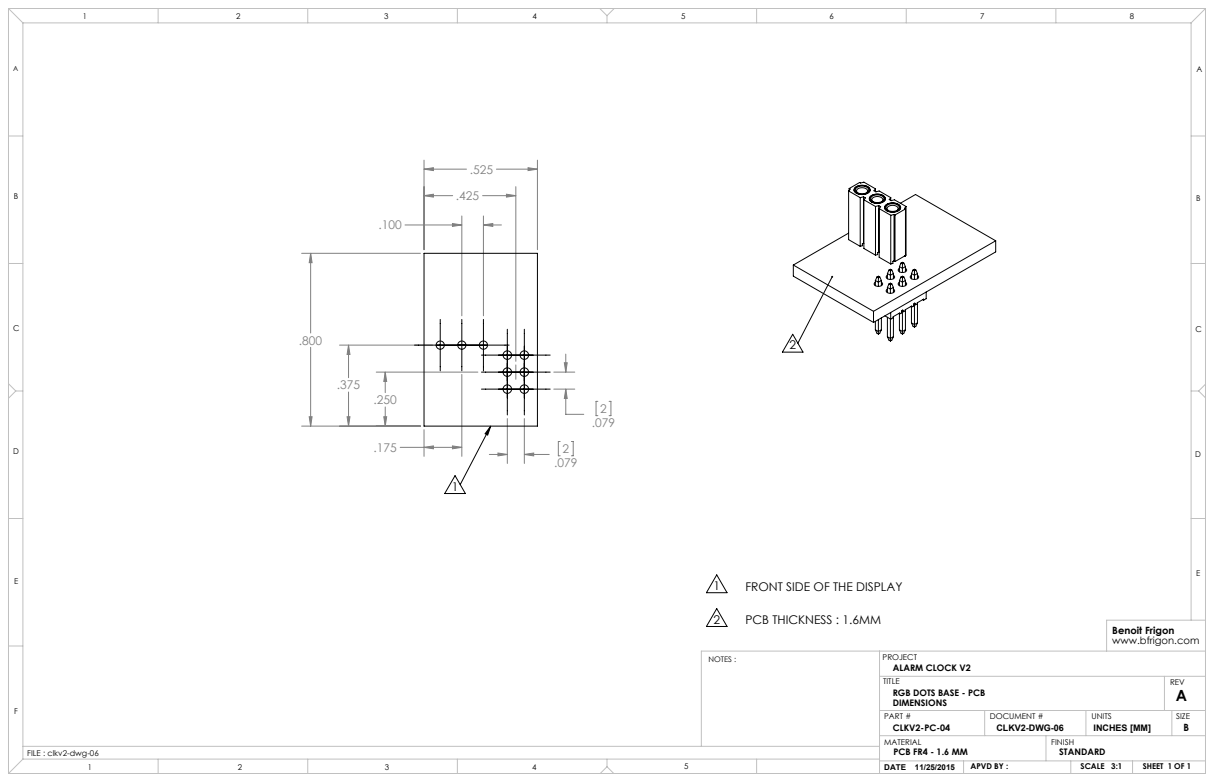
[picture p31: page 20]
FRONT SIDE OF THE DISPLAY; PCB THICKNESS : 1.6MM; REV; DOCUMENT #; UNITS; INCHES [MM]; SIZE; CLKV2-DWG-06; SCALE 3:1; NOTES :

Benoit Frigon
www.bfrigon.com

PROJECT
ALARM CLOCK V2
TITLE
RGB DOTS BASE - PCB
DIMENSIONS
PART #
CLKV2-PC-04
PCB FR4 - 1.6 MM
