bfrigon/alarm-clock-v2/drawings/mechanical/clkv2-dwg-14.pdf

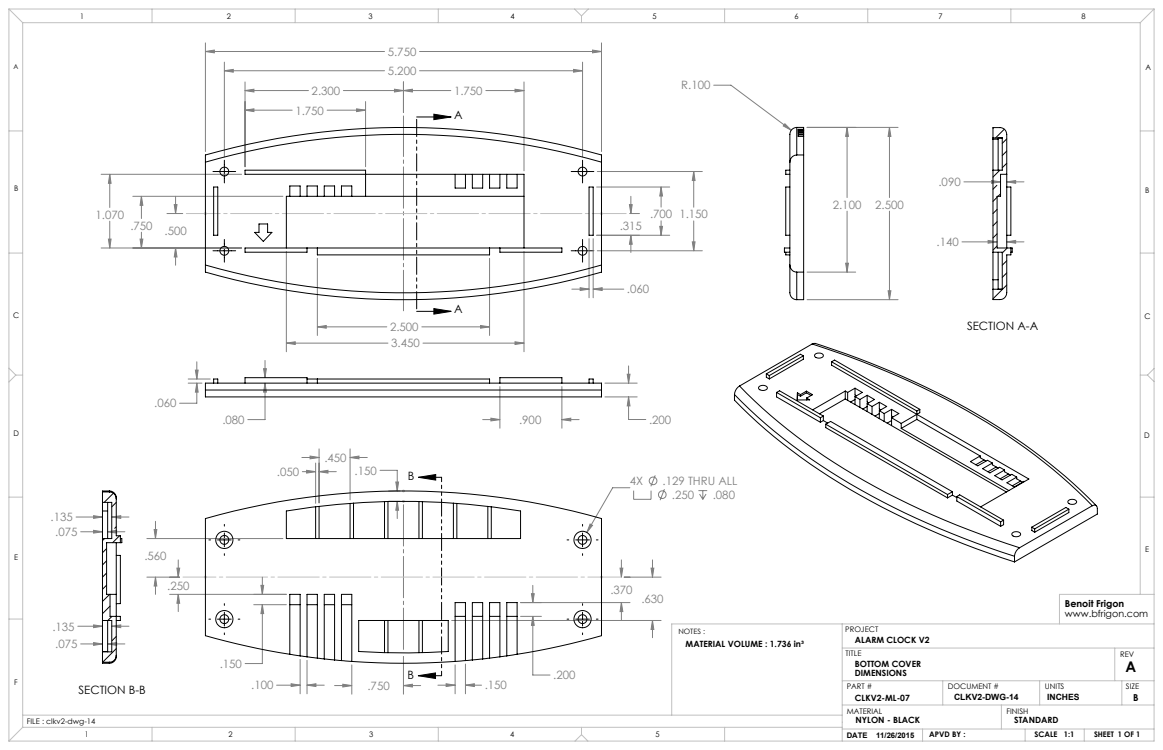
[picture p32: page 1]
.129 THRU ALL; SECTION A-A; SECTION B-B; SHEET 1 OF 1; ALARM CLOCK V2; BOTTOM COVER; PART #; DOCUMENT #; UNITS; DATE 11/26/2015; SCALE 1:1; FILE : clkv2-dwg-14; NYLON - BLACK; APVD BY :

Benoit Frigon
www.bfrigon.com

NOTES :
MATERIAL VOLUME : 1.736 in³
