bfrigon/alarm-clock-v2/drawings/mechanical/clkv2-dwg-03.pdf

0.05 x 0.1 PAD; 1 PCB THICKNESS : 0.8MM; SHEET 1 OF 1; ALARM CLOCK V2; RGB DOT - PCB; PART #; DOCUMENT #; UNITS; DATE 11/25/2015; SCALE 8:1; FILE : clkv2-dwg-03; PCB FR4 - 0.8 MM; BLACK SOLDERMASK; NOTES :; APVD BY :

Benoit Frigon
www.bfrigon.com
