bfrigon/alarm-clock-v2/drawings/mechanical/clkv2-dwg-06.pdf

FRONT SIDE OF THE DISPLAY; PCB THICKNESS : 1.6MM; SHEET 1 OF 1; DOCUMENT #; UNITS; INCHES [MM]; SCALE 3:1; FILE : clkv2-dwg-06; NOTES :; APVD BY :

Benoit Frigon
www.bfrigon.com

PROJECT
ALARM CLOCK V2
TITLE
RGB DOTS BASE - PCB
DIMENSIONS
PART #
CLKV2-PC-04
MATERIAL
PCB FR4 - 1.6 MM
DATE 11/25/2015
