bfrigon/alarm-clock-v2/drawings/mechanical/clkv2-dwg-07.pdf

PCB THICKNESS : 1.6MM; SHEET 1 OF 2; ALARM CLOCK V2; FRONT PANEL PCB; PART #; DOCUMENT #; UNITS; INCHES [MM]; DATE 11/25/2015; SCALE 2:1; FILE : clkv2-dwg-07; PCB FR4 - 1.6 MM; NOTES :; APVD BY :

Benoit Frigon
www.bfrigon.com

SHEET 2 OF 2; DOCUMENT #; UNITS; INCHES [MM]; SCALE 2:1; FILE : clkv2-dwg-07; NOTES :; APVD BY :

Benoit Frigon
www.bfrigon.com

PROJECT
ALARM CLOCK V2
TITLE
FRONT PANEL PCB
COMPONENTS POSITION
PART #
CLKV2-PC-05
MATERIAL
PCB FR4 - 1.6 MM
DATE 11/25/2015

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
