bfrigon/alarm-clock-v2/drawings/mechanical/clkv2-dwg-08.pdf

ELECTRODE PAD; PCB THICKNESS : 1.6MM; TOP SIDE; BOTTOM SIDE; SHEET 1 OF 2; ALARM CLOCK V2; TOUCH KEYPAD PCB; PART #; DOCUMENT #; UNITS; DATE 11/25/2015; SCALE 2:1; FILE : clkv2-dwg-08; PCB FR4 - 1.6 MM; NOTES :; APVD BY :

Benoit Frigon
www.bfrigon.com

SHEET 2 OF 2; DOCUMENT #; UNITS; SCALE 2:1; FILE : clkv2-dwg-08; NOTES :; APVD BY :

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

ABSOLUTE MINIMUM CLEARANCE
BETWEEN THE PCB AND BOTTOM OF THE
CAVITY.

Benoit Frigon
www.bfrigon.com

PROJECT
ALARM CLOCK V2
TITLE
TOUCH KEYPAD PCB
COMPONENTS CLEARANCE
PART #
CLKV2-PC-06
MATERIAL
PCB FR4 - 1.6 MM
DATE 11/25/2015
