bfrigon/alarm-clock-v2/drawings/mechanical/clkv2-dwg-20.pdf

SHEET 1 OF 2; ALARM CLOCK V2; RGB SEVEN-SEGMENTS DIGIT ASSEMBLY; PART #; DOCUMENT #; UNITS; DATE 11/25/2015; SCALE 2:1; FILE : clkv2-dwg-20; NOTES :; APVD BY :

Benoit Frigon
www.bfrigon.com

DIFFUSER SHELL; SHEET 2 OF 2; DOCUMENT #; UNITS; SCALE 2:1; FILE : clkv2-dwg-20; NOTES :; APVD BY :

ITEM NO. | PART NUMBER | DRAWING ID | DESCRIPTION | QTY.

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

PUT SILICON AROUND THE
EDGES
2 FILL CAVITY WITH WHITE
TRANSLUCENT EPOXY

Benoit Frigon
www.bfrigon.com

PROJECT
ALARM CLOCK V2
TITLE
RGB SEVEN-SEGMENTS DIGIT ASSEMBLY
ASSEMBLY STEPS
PART #
CLKV2-AS-01
MATERIAL
DATE 11/25/2015
