bfrigon/alarm-clock-v2/drawings/mechanical/clkv2-dwg-21.pdf

SHEET 1 OF 2; ALARM CLOCK V2; RGB DOTS ASSEMBLY; PART #; DOCUMENT #; UNITS; DATE 11/25/2015; SCALE 3:1; FILE : clkv2-dwg-21; NOTES :; APVD BY :

Benoit Frigon
www.bfrigon.com

BOARD ASSEMBLY; DIFFUSER SHELL; SHEET 2 OF 2; ALARM CLOCK V2; RGB DOTS ASSEMBLY; PART #; DOCUMENT #; UNITS; DATE 11/25/2015; SCALE 3:1; FILE : clkv2-dwg-21; NOTES :; ASSEMBLY STEPS; APVD BY :

ITEM NO. | PART NUMBER | MFG. | DRAWING ID | DESCRIPTION | QTY.

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

PUT SILICON AROUND THE
EDGES
FILL CAVITY WITH WHITE
TRANSLUCENT EPOXY

Benoit Frigon
www.bfrigon.com
