bfrigon/alarm-clock-v2/drawings/mechanical/clkv2-dwg-22.pdf

SHEET 1 OF 2; ALARM CLOCK V2; TOP PANEL ASSEMBLY; PART #; DOCUMENT #; UNITS; DATE 11/25/2015; SCALE 3:1; FILE : clkv2-dwg-22; NOTES :; APVD BY :

Benoit Frigon
www.bfrigon.com

SHEET 2 OF 2; ALARM CLOCK V2; TOP PANEL ASSEMBLY; PART #; DOCUMENT #; UNITS; DATE 11/25/2015; SCALE 3:2; FILE : clkv2-dwg-22; NOTES :; ASSEMBLY STEPS; APVD BY :

ITEM NO. | PART NUMBER | DRAWING ID | DESCRIPTION | QTY.

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

Benoit Frigon
www.bfrigon.com
