bfrigon/alarm-clock-v2/drawings/schematics/clkv2-pc-01.pdf

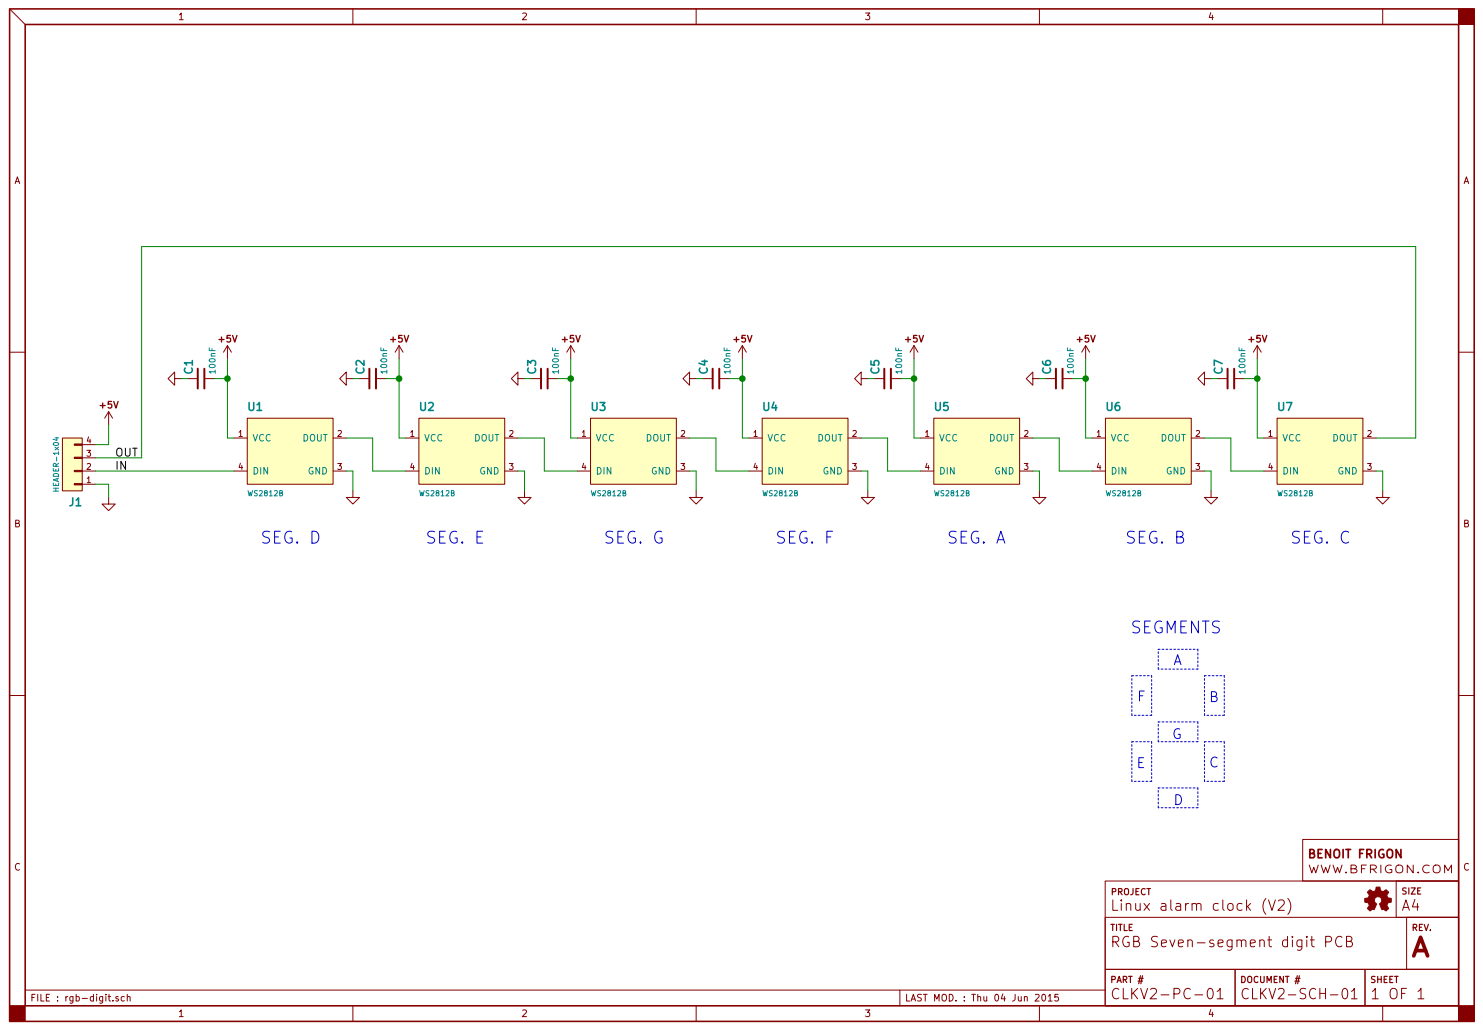
[picture p33: page 1]

BC Linux alarm clock (V2)

TITLE WWW.BFRIGON.COM | SIZE A4

REV. PROJECT RGB Seven-segment digit PCB

PART # | | A

DOCUMENT # CLKV2-PC-01 | SHEET CLKV2-SCH-01
