bfrigon/alarm-clock-v2/drawings/schematics/clkv2-pc-03.pdf

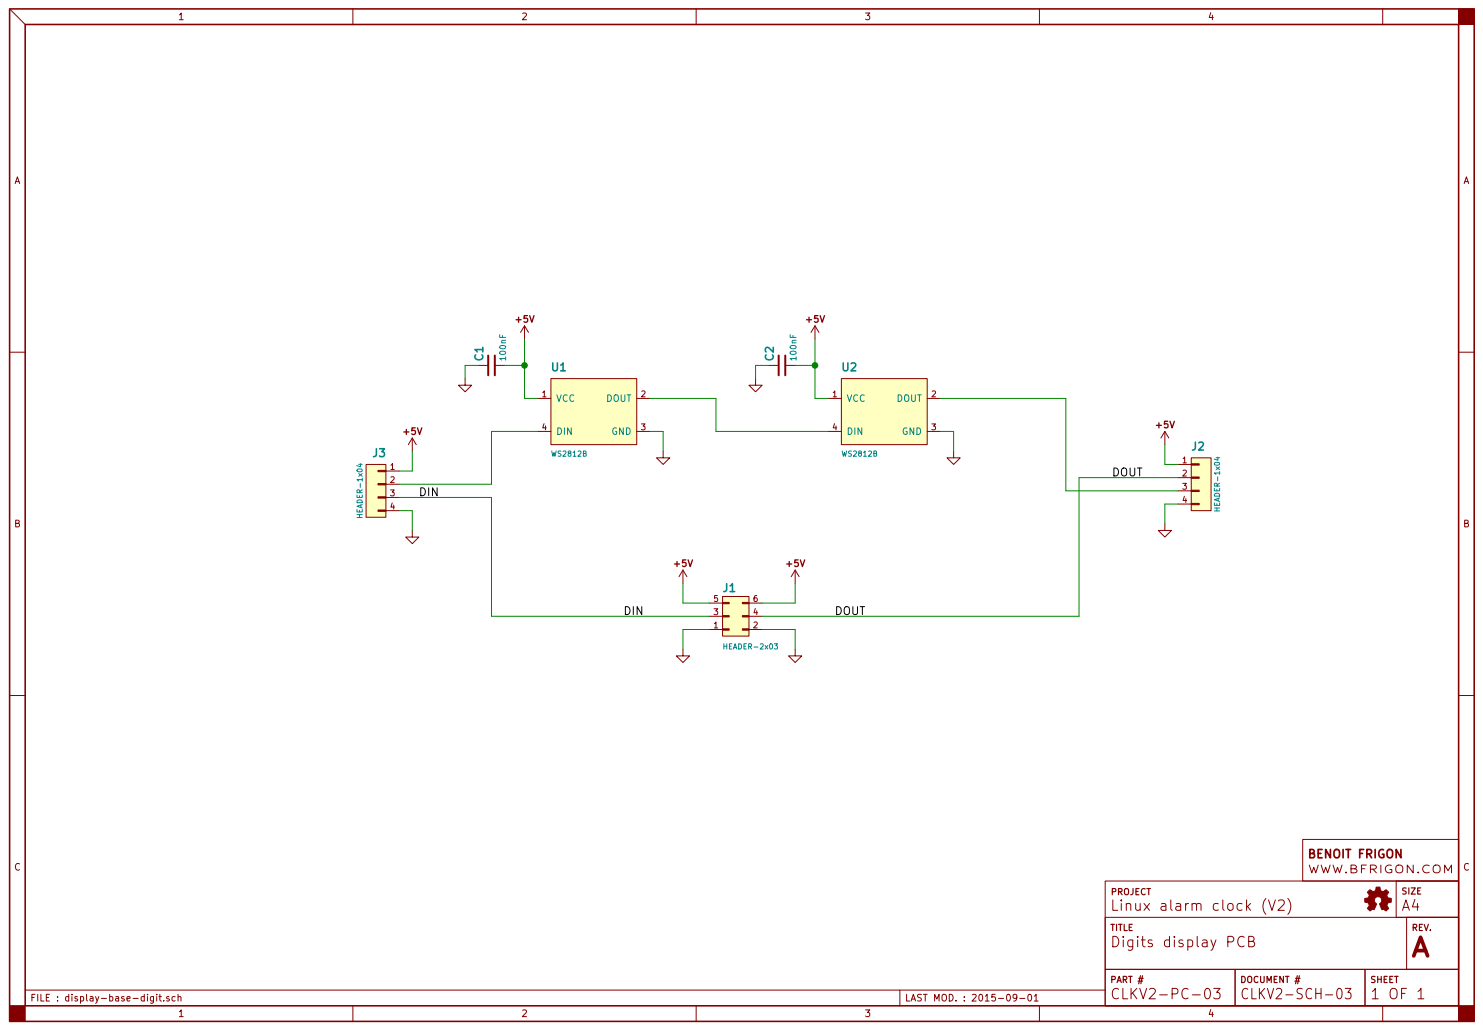
[picture p34: page 1]

BC Linux alarm clock (V2)

REV. PROJECT Digits display PCB
