bfrigon/alarm-clock-v2/drawings/schematics/clkv2-pc-04.pdf

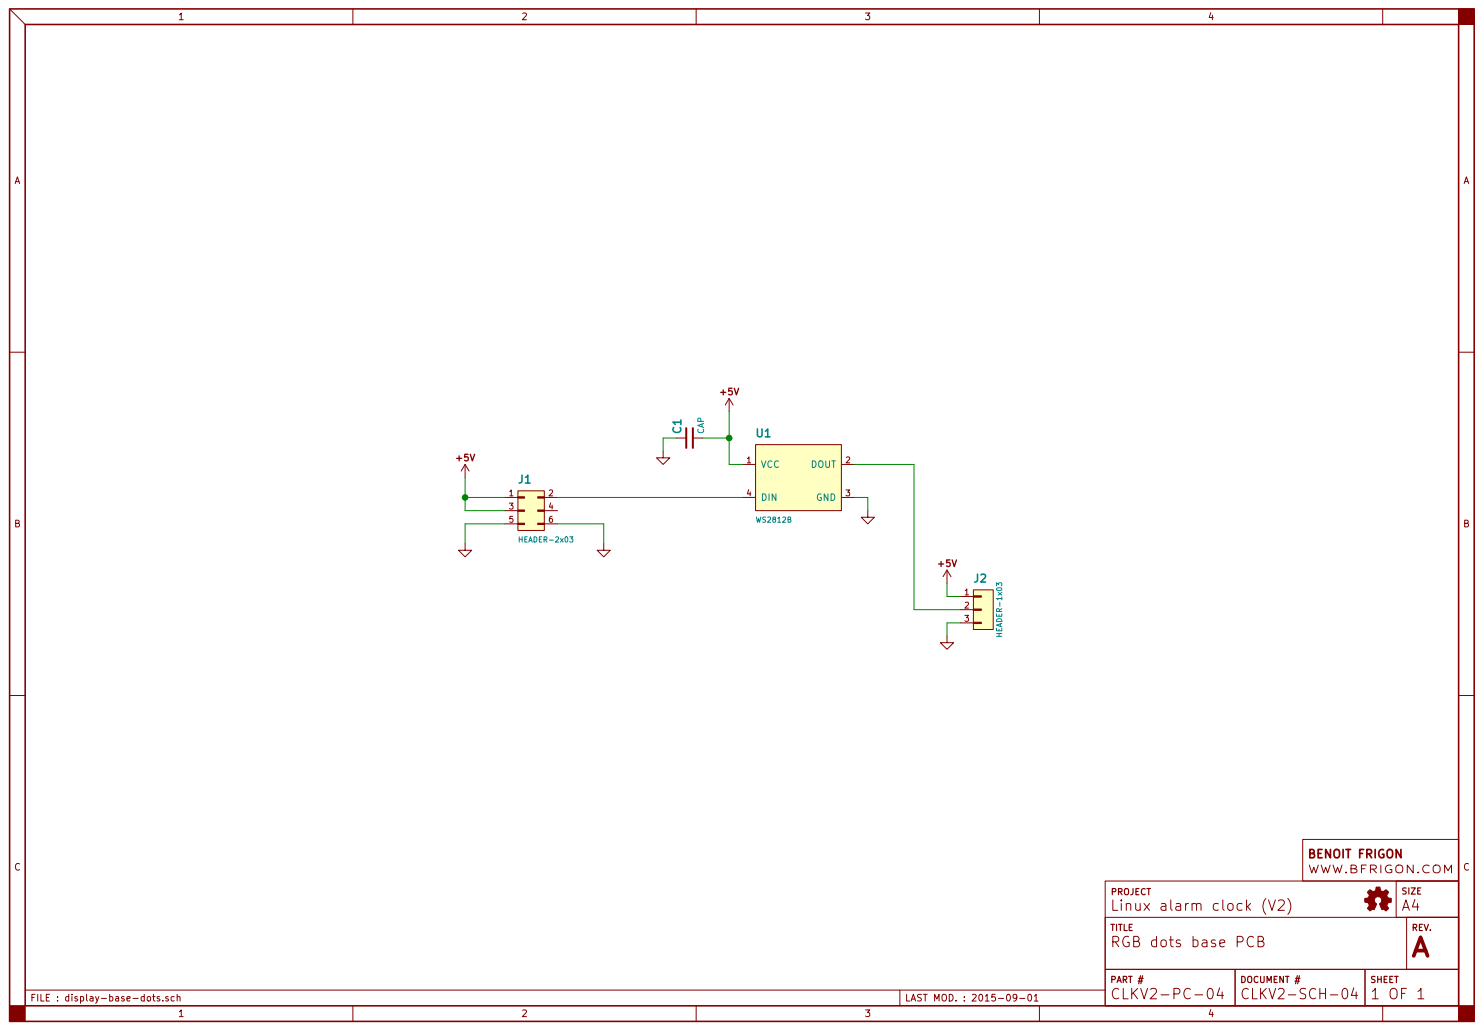
[picture p35: page 1]

BC Linux alarm clock (V2)

TITLE WWW.BFRIGON.COM | SIZE A4

REV. PROJECT RGB dots base PCB

PART # | | | A

DOCUMENT # CLKV2-PC-04 | SHEET CLKV2-SCH-04
