bfrigon/alarm-clock-v2/drawings/schematics/clkv2-pc-06.pdf

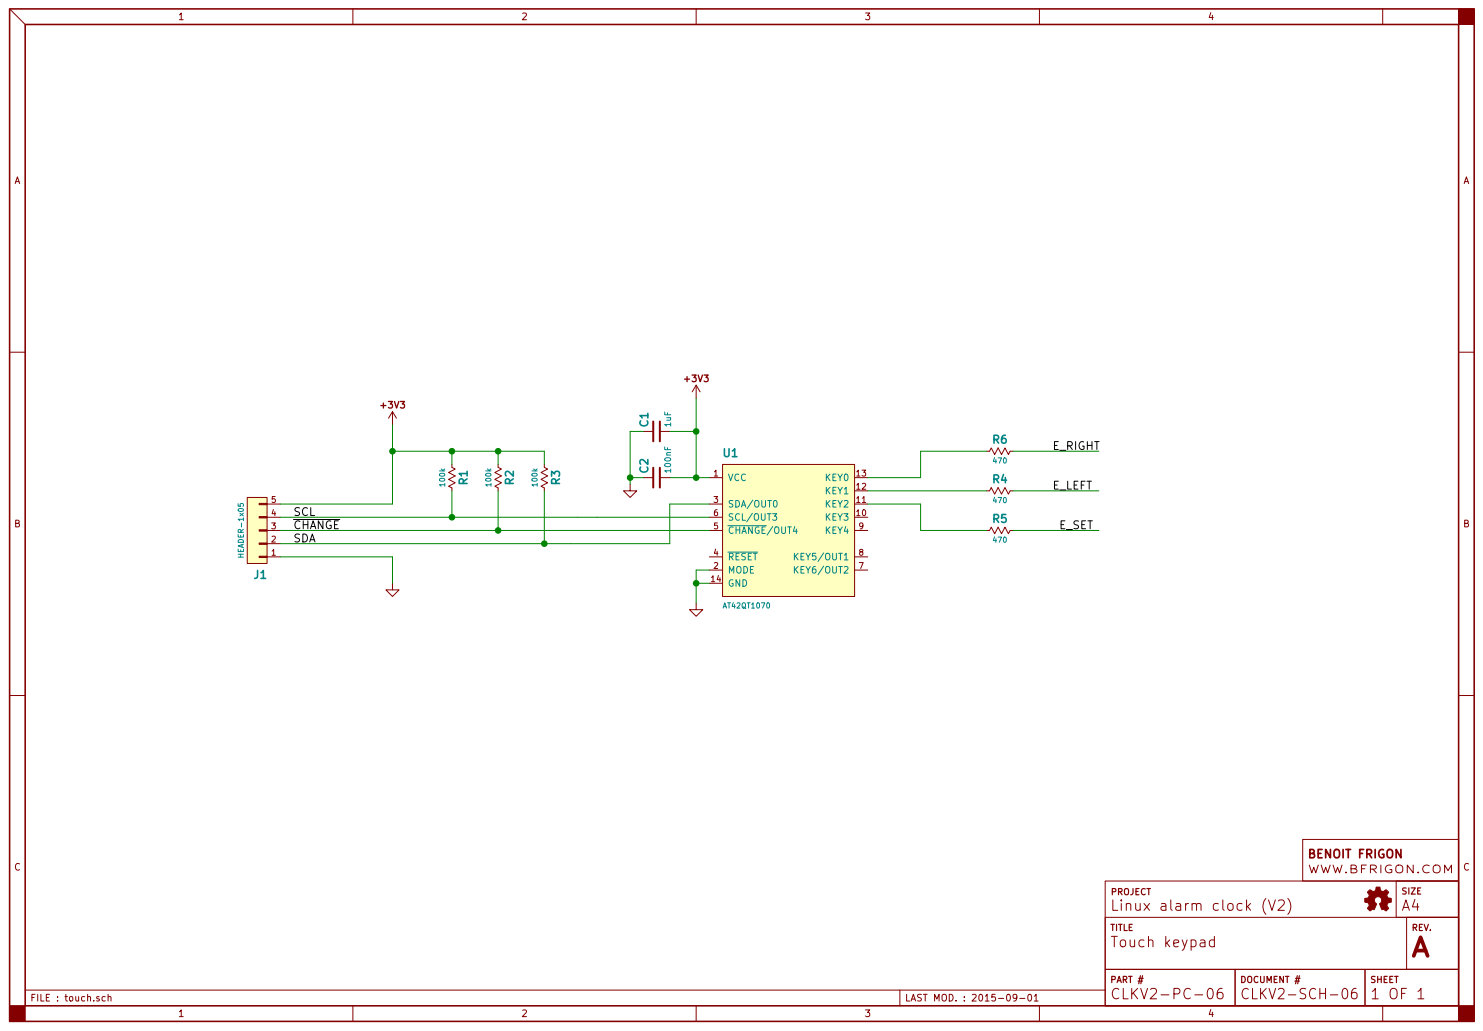
[picture p36: page 1]

BC Linux alarm clock (V2)

TITLE WWW.BFRIGON.COM | SIZE A4

REV. PROJECT Touch keypad

PART # | | | A

DOCUMENT # CLKV2-PC-06 | SHEET CLKV2-SCH-06
