bfrigon/alarm-clock-v2/drawings/schematics/clkv2-pc-02.pdf

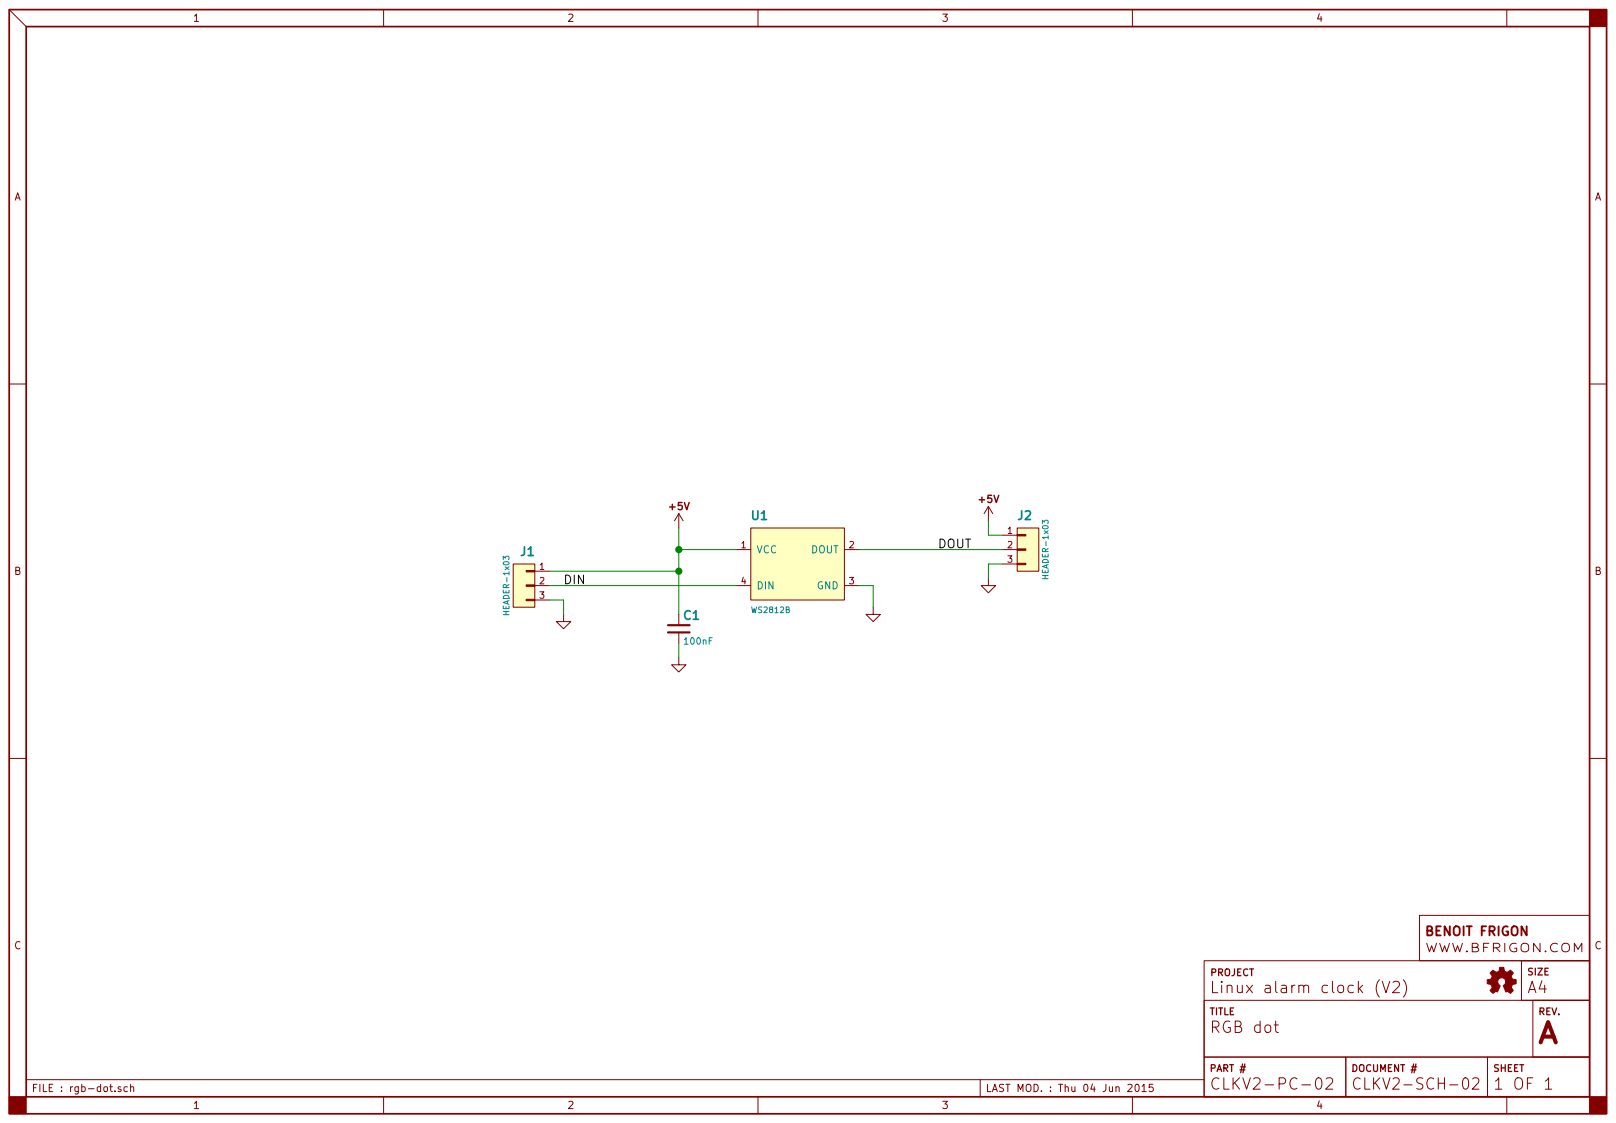
[picture p37: page 1]

SIZE A4

PART # | | A

DOCUMENT # CLKV2-PC-02 | SHEET CLKV2-SCH-02
