bfrigon/alarm-clock-v2/pcb/touch/touch.kicad_pcb

## KiCad design pcb/touch/touch.kicad_pcb (2015-11-26)

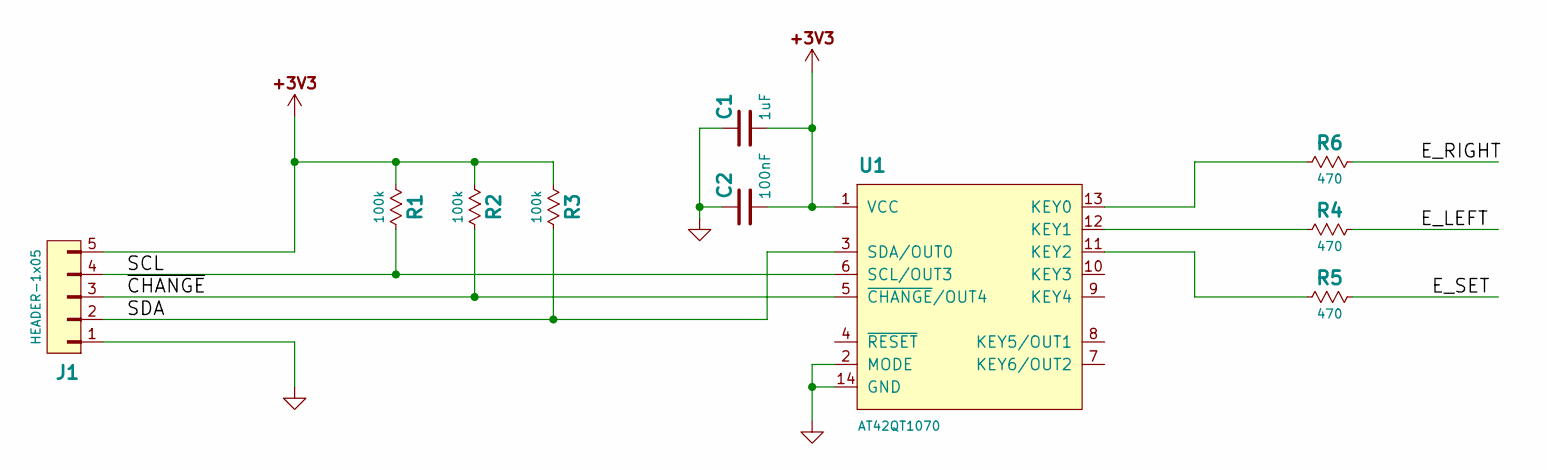
[picture p38: schematic touch.sch, Touch keypad]

Parts:
C1: 1uF; C-0805
C2: 100nF; C-0603
J1: HEADER-1x05; WP-50mil-1x05
R1, R2, R3: 100k; C-0603
R4, R5, R6: 470; C-0603
U1: AT42QT1070; 14N

Connections:
+3V3: C1.1, C2.1, J1.5, R1.1, R2.1, R3.1, U1.1 (VCC)
/E_LEFT: R4.2
/E_RIGHT: R6.2
/E_SET: R5.2
/SCL: J1.4, R1.2, U1.6 (SCL/OUT3)
/SDA: J1.2, R3.2, U1.3 (SDA/OUT0)
/~CHANGE: J1.3, R2.2, U1.5 (~CHANGE~/OUT4)
GND: C1.2, C2.2, J1.1, U1.2 (MODE), U1.14 (GND)
unnamed: R4.1, U1.12 (KEY1)
unnamed: R5.1, U1.11 (KEY2)
unnamed: R6.1, U1.13 (KEY0)

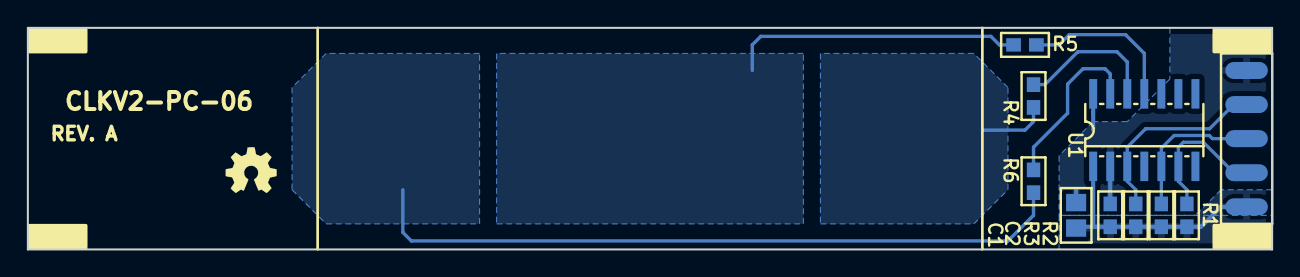
[picture p39: board touch.kicad_pcb from below]

Board: 2 copper layers, 92.7 x 16.5 mm, 11 parts (11 on the bottom side), 8 nets.

Other parts of the board:
LOGO-OSHW-150: OSHW; LOGO-OSHW-150
