bfrigon/alarm-clock-v2/pcb/rgb-dot/rgb-dot.kicad_pcb

## KiCad design pcb/rgb-dot/rgb-dot.kicad_pcb (2015-11-04)

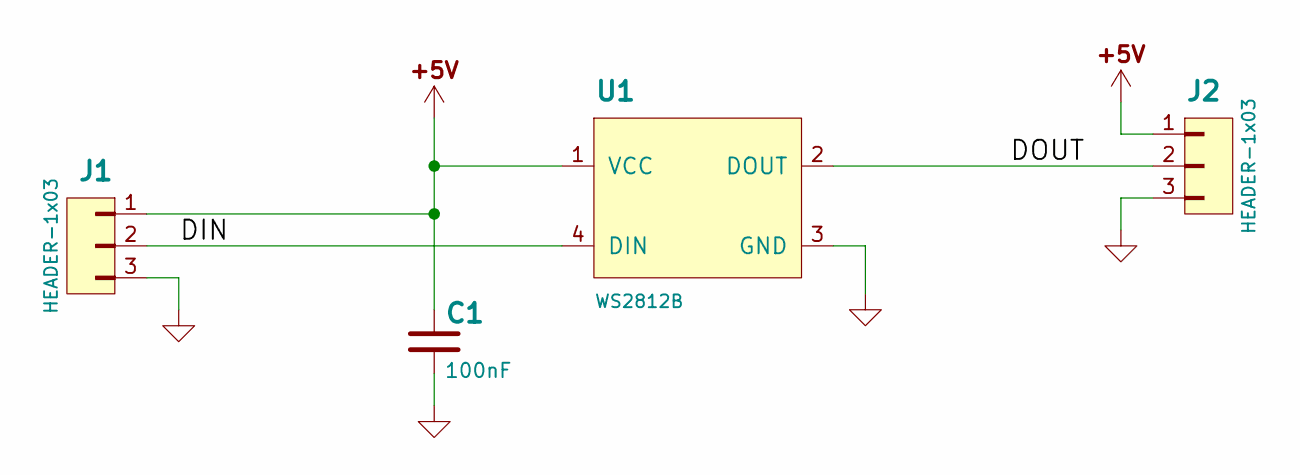
[picture p40: schematic rgb-dot.sch, RGB dot]

Parts:
C1: 100nF; C-0603
J1, J2: HEADER-1x03; WP-50mil-1x03
U1: WS2812B; LED-5050

Connections:
+5V: C1.2, J1.1, J2.1, U1.1 (VCC)
/DIN: J1.2, U1.4 (DIN)
/DOUT: J2.2, U1.2 (DOUT)
GND: C1.1, J1.3, J2.3, U1.3 (GND)

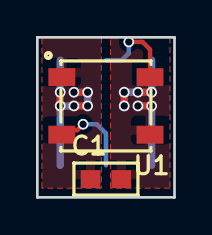
[picture p41: board rgb-dot.kicad_pcb from above]

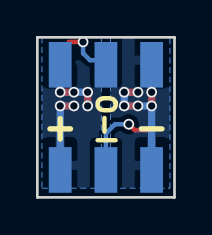
[picture p42: board rgb-dot.kicad_pcb from below]

Board: 2 copper layers, 7.6 x 8.9 mm, 4 parts (2 on the bottom side), 4 nets.
