bfrigon/alarm-clock-v2/pcb/rgb-digit/rgb-digit.kicad_pcb

## KiCad design pcb/rgb-digit/rgb-digit.kicad_pcb (2015-11-04)

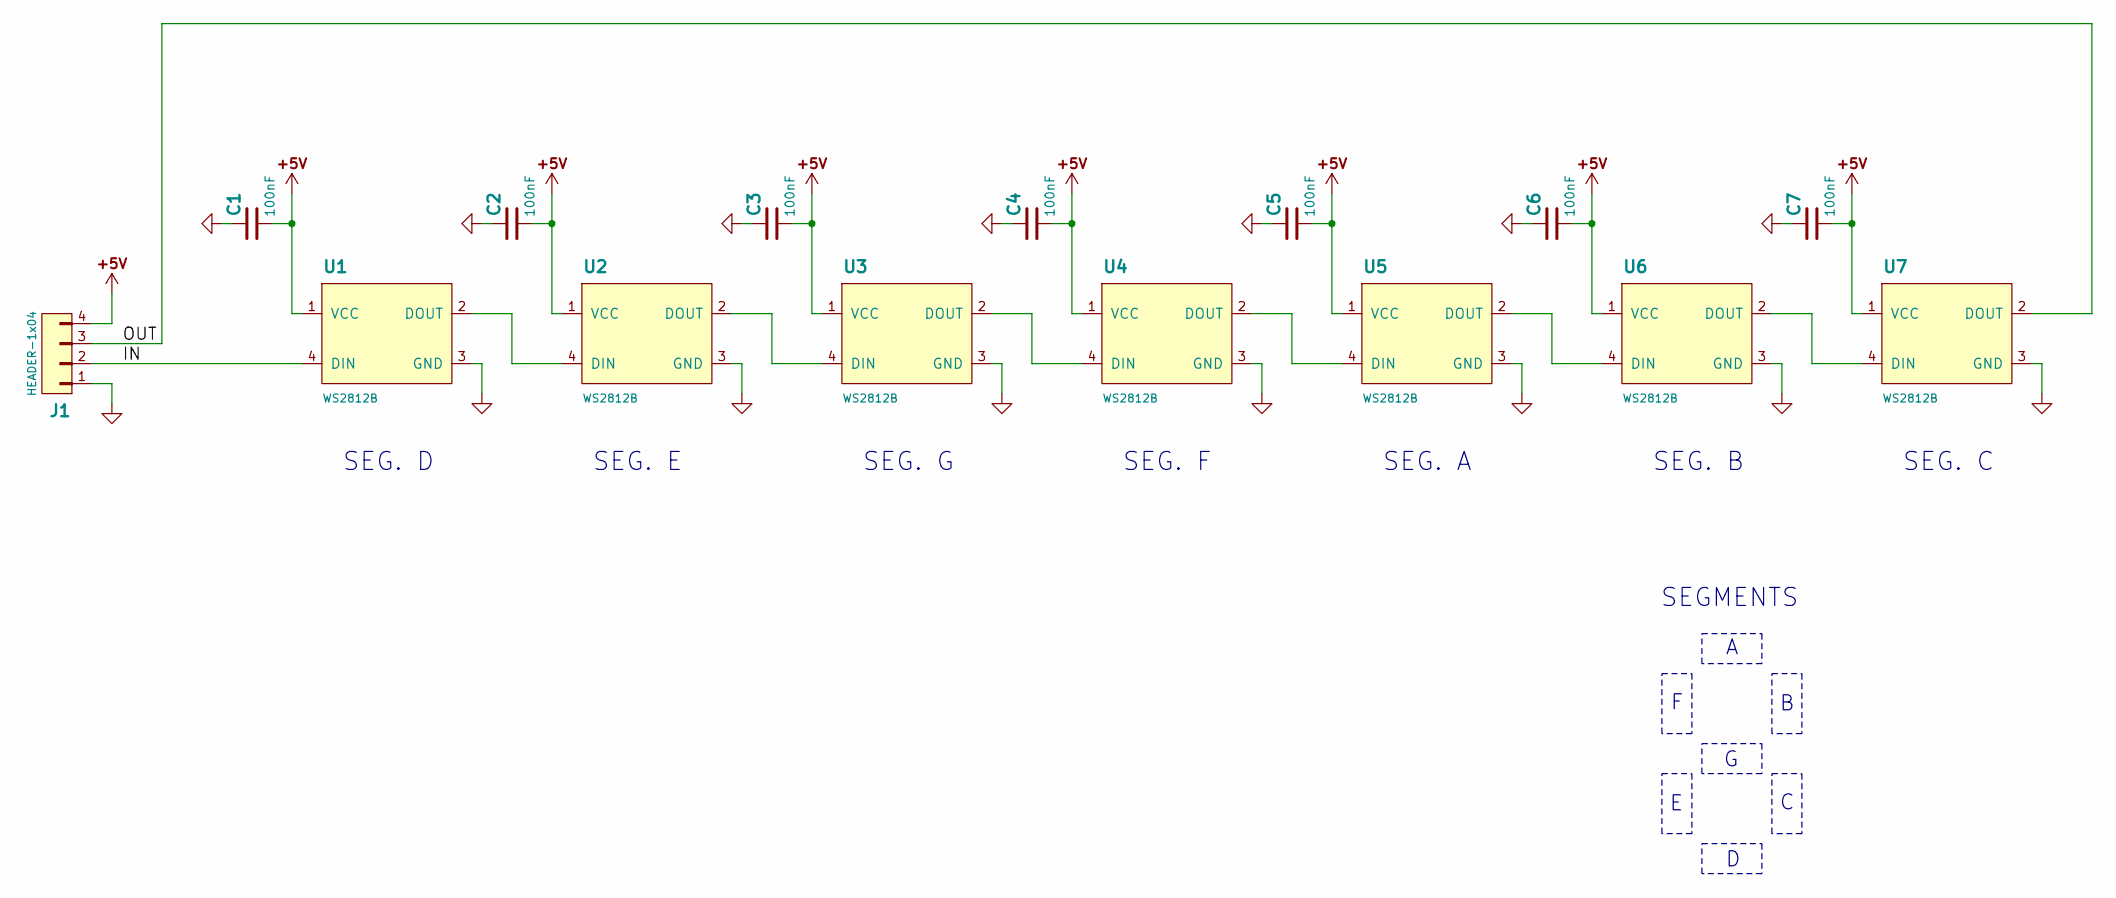
[picture p43: schematic rgb-digit.sch, RGB Seven-segment digit PCB]

Parts:
C1, C2, C3, C4, C5, C6, C7: 100nF; C-0603
J1: HEADER-1x04; WP-50mil-1x04
U1, U2, U3, U4, U5, U6, U7: WS2812B; LED-5050

Connections:
+5V: C1.1, C2.1, C3.1, C4.1, C5.1, C6.1, C7.1, J1.4, U1.1 (VCC), U2.1 (VCC), U3.1 (VCC), U4.1 (VCC), U5.1 (VCC), U6.1 (VCC), U7.1 (VCC)
/IN: J1.2, U1.4 (DIN)
/OUT: J1.3, U7.2 (DOUT)
GND: C1.2, C2.2, C3.2, C4.2, C5.2, C6.2, C7.2, J1.1, U1.3 (GND), U2.3 (GND), U3.3 (GND), U4.3 (GND), U5.3 (GND), U6.3 (GND), U7.3 (GND)
unnamed: U1.2 (DOUT), U2.4 (DIN)
unnamed: U2.2 (DOUT), U3.4 (DIN)
unnamed: U3.2 (DOUT), U4.4 (DIN)
unnamed: U4.2 (DOUT), U5.4 (DIN)
unnamed: U5.2 (DOUT), U6.4 (DIN)
unnamed: U6.2 (DOUT), U7.4 (DIN)

Notes on the sheet:
SEG. D
SEG. E
SEG. G
SEG. F
SEG. A
SEG. B
SEG. C
SEGMENTS

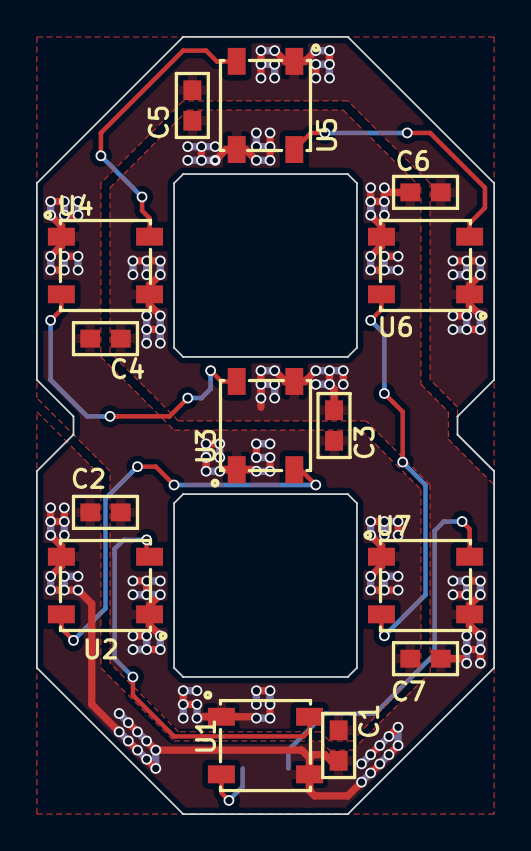
[picture p44: board rgb-digit.kicad_pcb from above]

Board: 2 copper layers, 25.4 x 43.2 mm, 15 parts (1 on the bottom side), 10 nets.
