bfrigon/alarm-clock-v2/pcb/front-panel/front-panel.kicad_pcb

## KiCad design pcb/front-panel/front-panel.kicad_pcb (2015-11-04)

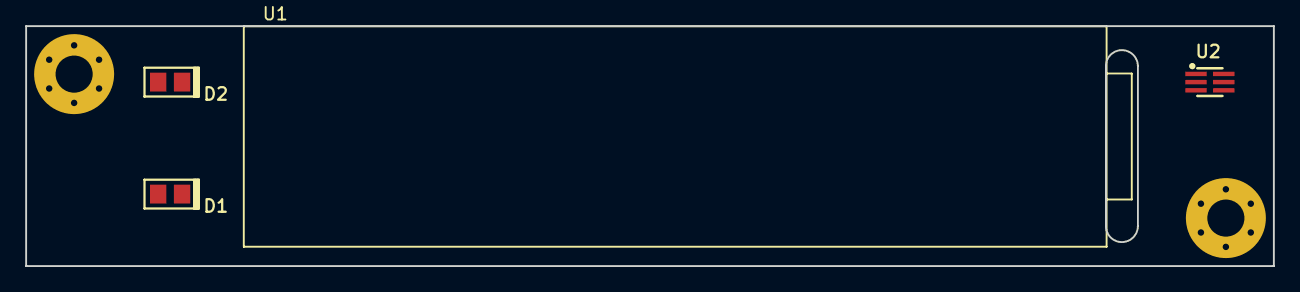
[picture p45: board front-panel.kicad_pcb from above]

Board: 2 copper layers, 99.1 x 19.0 mm, 7 parts (1 on the bottom side), 4 nets, no tracks yet.

Parts:
D1, D2: LED; LED-0805
J1: HEADER-1x05; WP-50mil-1x05
REF: Hole-Screw-#4
REF#2: Hole-Screw-#4
U1: ER-OLED1602-4W; LCD-ER-OLED1602
U2: TSL2561; 6

Connections:
+3V3: J1.1, U1.6, U1.10
/SCL: J1.3, U1.18
/SDA: J1.2, U1.19, U1.20
GND: J1.5, U1.1, U1.3, U1.9, U1.11, U1.13, U1.16, U1.17, U1.21, U1.22, U1.23, U1.24, U1.25, U1.27, U1.28, U1.29, U1.30, U1.33
