bfrigon/alarm-clock-v2/pcb/display-base-digit/display-base-digit.kicad_pcb

## KiCad design pcb/display-base-digit/display-base-digit.kicad_pcb (2015-09-01)

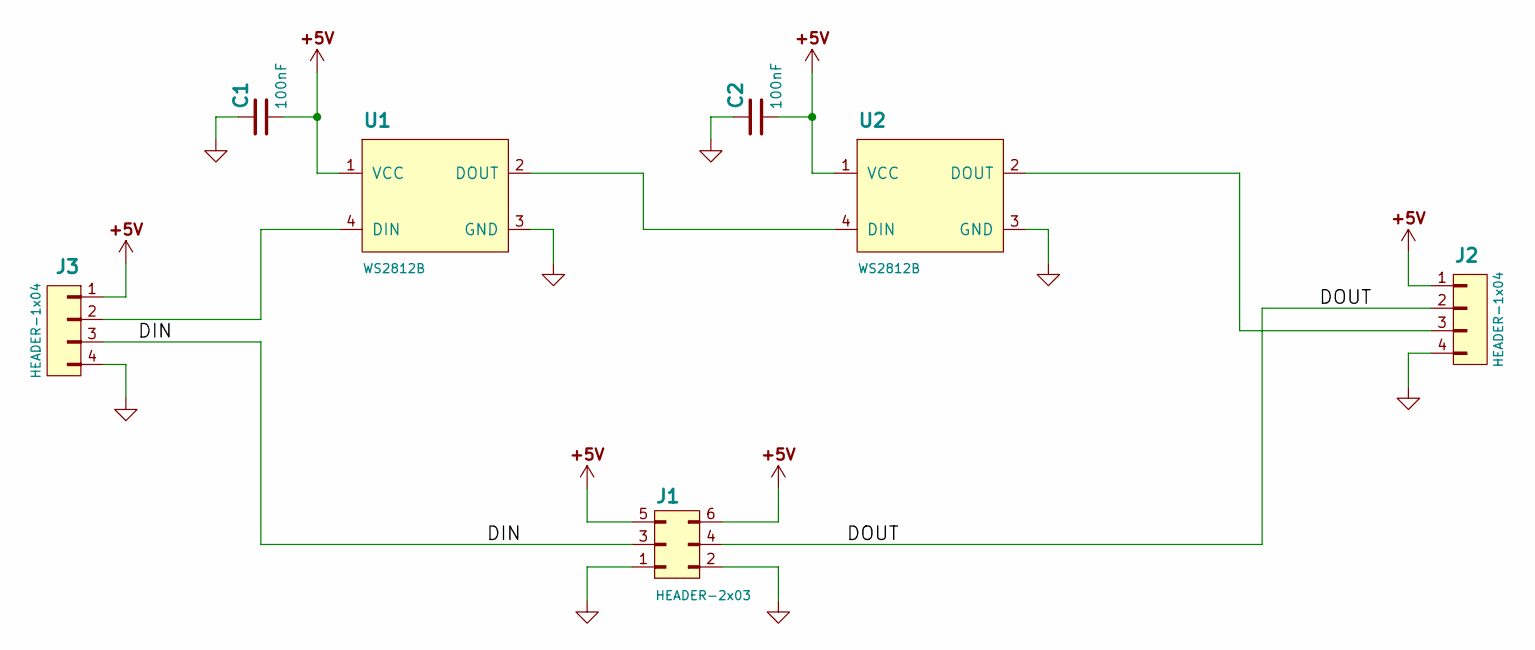
[picture p46: schematic display-base-digit.sch, Digits display PCB]

Parts:
C1, C2: 100nF; C-0603
J1: HEADER-2x03; 2MM-HDR-M-2x03
J2, J3: HEADER-1x04; HDR-M-1x04
U1, U2: WS2812B; LED-5050

Connections:
+5V: C1.1, C2.1, J1.5, J1.6, J2.1, J3.1, U1.1 (VCC), U2.1 (VCC)
/DIN: J1.3, J3.3
/DOUT: J1.4, J2.2
GND: C1.2, C2.2, J1.1, J1.2, J2.4, J3.4, U1.3 (GND), U2.3 (GND)
unnamed: J2.3, U2.2 (DOUT)
unnamed: J3.2, U1.4 (DIN)
unnamed: U1.2 (DOUT), U2.4 (DIN)

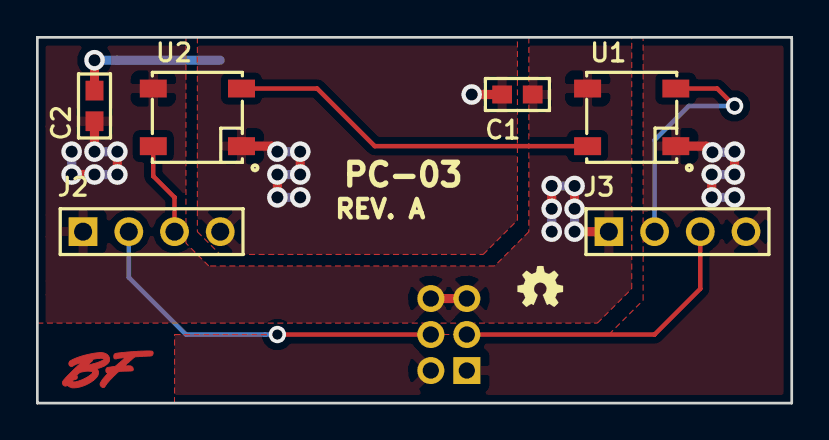
[picture p47: board display-base-digit.kicad_pcb from above]

Board: 2 copper layers, 41.9 x 20.3 mm, 9 parts (1 on the bottom side), 7 nets.

Other parts of the board:
LOGO-OSHW-100: OSHW; LOGO-OSHW-100
SIGNATURE: LOGO; SIGNATURE
