bfrigon/alarm-clock-v2/(commit log)

2015-06-05 Added STL files
    [digits - walls.stl, dots - wall.stl, rgb-dot.kicad_pcb]
2015-09-01 Added STD models
    [Bottom cover.STL, Case.STL, Diffuser shell - Digit.STL, Diffuser shell - Dots.STL, LCD Window - Bracket.STL, Top panel - Case.STL, Vertical support.STL, digits - walls.stl]
2015-09-01 Updated PCB pc-01 pc-02, Added display base pcb (pc-03, pc-04)
    [display-base-digit.kicad_pcb, display-base-digit.sch, display-base-dots.kicad_pcb, display-base-dots.sch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]
2015-09-01 Added pdf schematics
2015-09-01 Updated gerber files for 0.8mm 5x5 panel
    [panel-B_Mask.gbs, panel-B_SilkS.gbo, panel-F_Mask.gts, panel.gbl, panel.gbo, panel.gbs, panel.gko, panel.gtl]
2015-11-04 Updated schematics
    [front-panel.kicad_pcb, front-panel.sch, rgb-digit.kicad_pcb, rgb-dot.kicad_pcb, touch.kicad_pcb, touch.sch]
2015-11-04 Updated STL files
    [Bottom cover.STL, Case.STL, Diffuser shell - Digit.STL, Diffuser shell - Dots.STL, LCD Window - Bracket.STL, Top panel - Case.STL, Top panel - Vertical support.STL, Vertical support.STL]
2015-11-26 Updated directory structure
    [Bottom cover.STL, Case.STL, Diffuser shell - Digit.STL, Diffuser shell - Dots.STL, LCD Window - Bracket.STL, Top panel - Case.STL, Top panel - Vertical support.STL]
2015-11-26 Modified keep-out zones
    [touch.kicad_pcb]
2015-11-26 Added material volume in drawings of 3D printed parts
